js214/FS720_layout/ocxo_mount/FAB_NOTES.txt

FABRICATION NOTES

1. BOARD IS NOT IMPEDANCE CONTROLLED.

2. OVERALL THICKNESS IS 1.6 mm. MATERIAL IS
     FR4 TG155.

3. ANY STACKUP ACCEPTABLE.

4. SURFACE FINISH IS ENIG.
     GOLD THICKNESS 2 μin = 0.05 μm.

5. VIAS SHOULD BE EPOXY FILLED & CAPPED.
