js214/FS720_layout/motherboard/fs.step

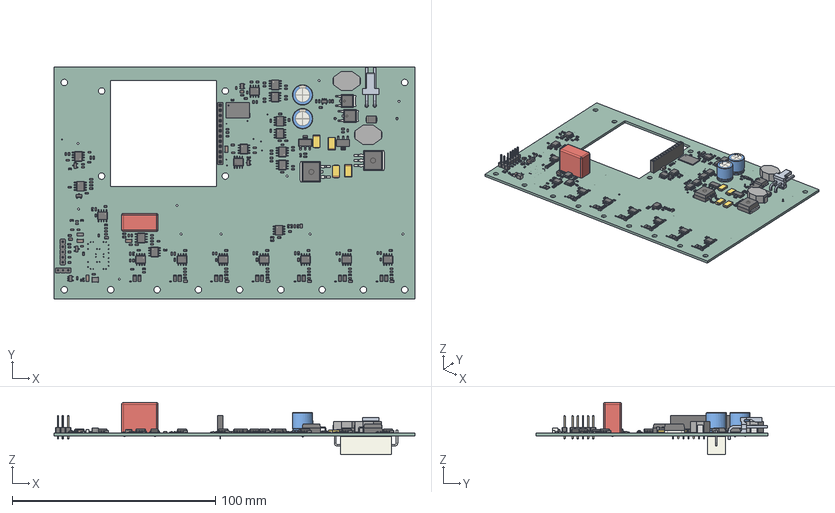
[picture p1: CAD file, 2026-08-03]
motherboard/fs.step
177.8 x 114.3 x 25.7 mm
C_1206_3216Metric x 4
R_0603_1608Metric x 88
SOT-23 x 4
C_0603_1608Metric x 59
R_1206_3216Metric x 14
SO-8_3.9x4.9mm_P1.27mm x 21
TSOT-23-5 x 3
C_0402_1005Metric x 8
L_0603_1608Metric x 21
CP_EIA_6032_15_Kemet_U x 4
C_Rect_L180mm_W90mm_P1500mm_FKS3_FKP3
L_0805_2012Metric x 9
C_0805_2012Metric x 2
a52d3817-9c39-11ed-93f0-dde97e994e83_part
a52d3818-9c39-11ed-93f0-dde97e994e83_part
a52d3819-9c39-11ed-93f0-dde97e994e83_part
CP_Radial_D100mm_P500mm x 2
PinHeader_1x05_P254mm_Vertical
a3dd6ad7-9c39-11ed-93f0-dde97e994e83_part
a3dd6ad8-9c39-11ed-93f0-dde97e994e83_part
a3dd6ad9-9c39-11ed-93f0-dde97e994e83_part
PinHeader_1x03_P254mm_Vertical
932d09b3-9c39-11ed-93f0-dde97e994e83_part x 2
932d09b4-9c39-11ed-93f0-dde97e994e83_part x 2
932d09b5-9c39-11ed-93f0-dde97e994e83_part x 2
SOT-223 x 2
PinSocket_1x12_P2.54mm_Vertical
L_1210_3225Metric
SOIC-8_3.9x4.9mm_P1.27mm
C-640389-2
D_SMB
L_1206_3216Metric
R_Axial_Power_L250mm_W90mm_P3048mm
fs_PCB
