js214/FS720_layout/ocxo_mount/ocxo_mount.step

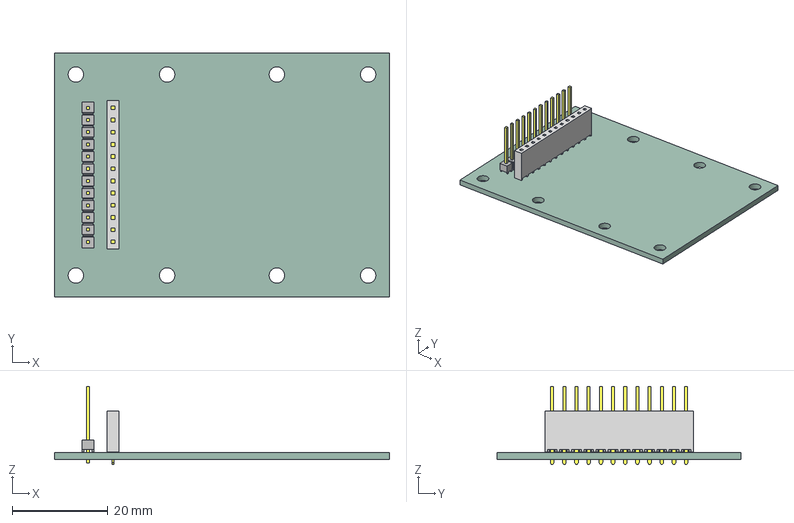
[picture p2: CAD file, 2026-08-03]
ocxo_mount/ocxo_mount.step
69.8 x 50.8 x 16.4 mm
T1SSW-112-01-G-S
P2SSW-112-01-G-S
HMTSW-112-22-L-S-440-LL_body
HMTSW-112-22-S-440-LL
ocxo_mount_PCB
