js214/FS720_layout/ocxo_mount/sch.pdf

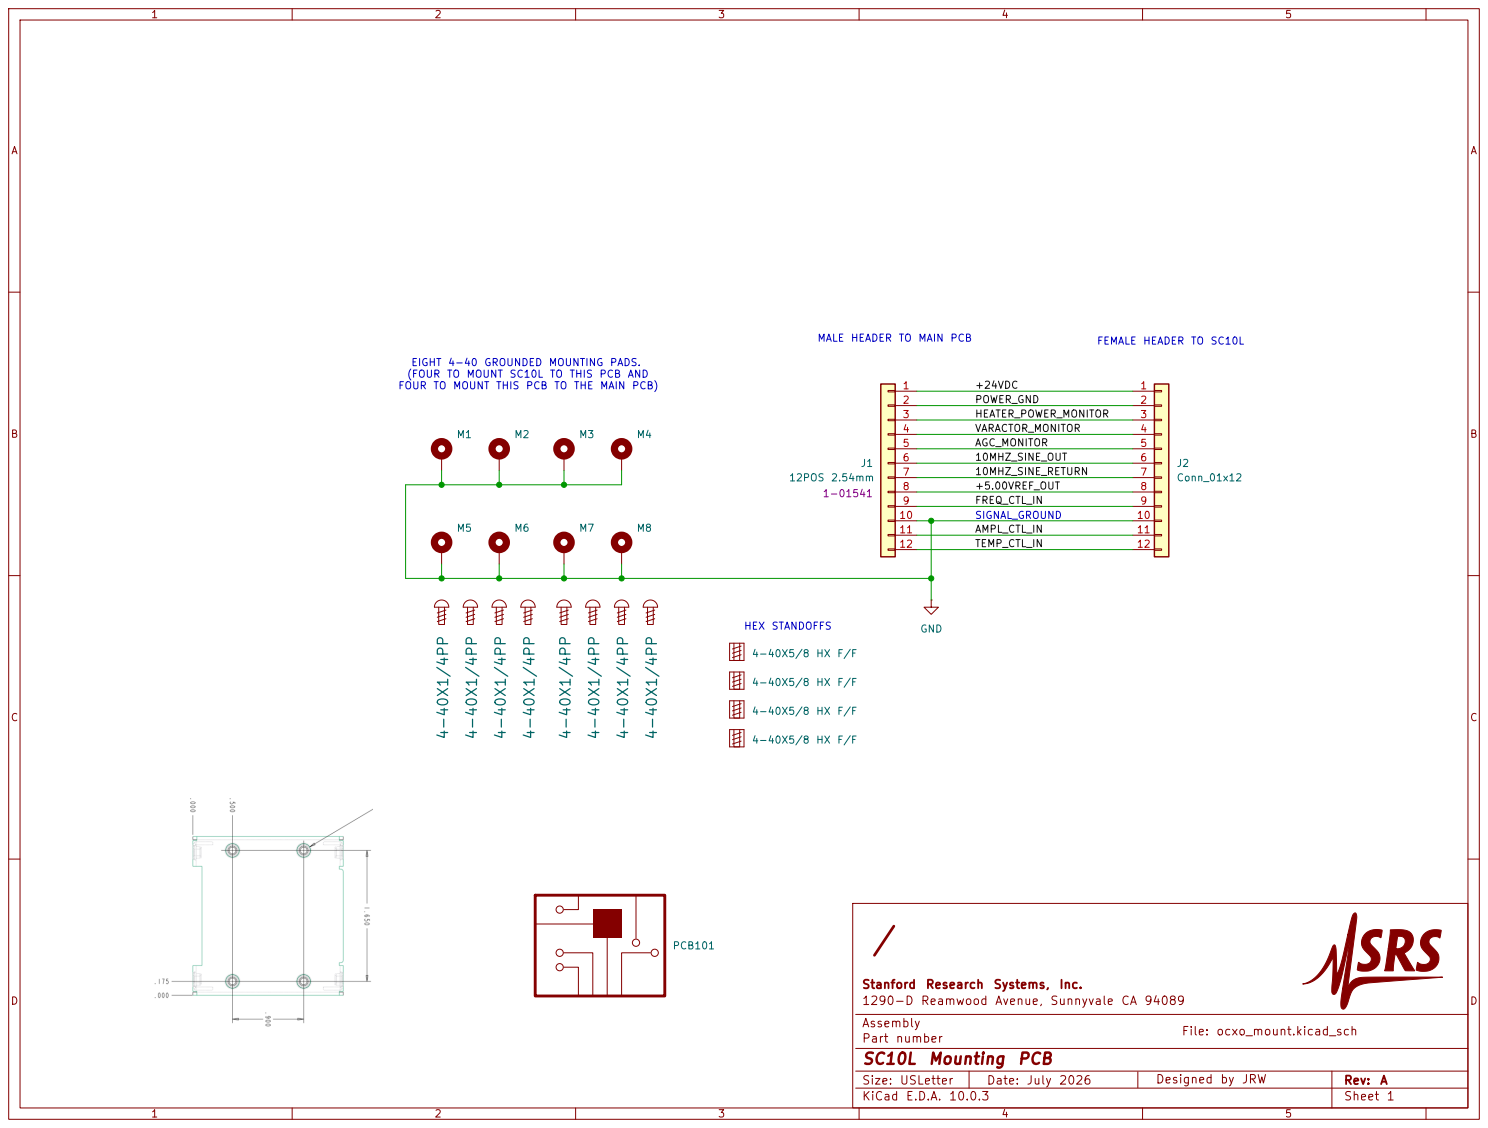
[picture p3: page 1]

11 | AMPL_CTL_IN 11
12 | 12

Stanford Research Systems, Inc.
1290-D Reamwood Avenue, Sunnyvale CA 94089
Assembly
Part number
SC10L Mounting PCB

Size: USLetter | Designed by JRW | Rev: A
KiCad E.D.A. 10.0.3 | | Sheet 1
