js214/FS720_layout/motherboard/sch.pdf

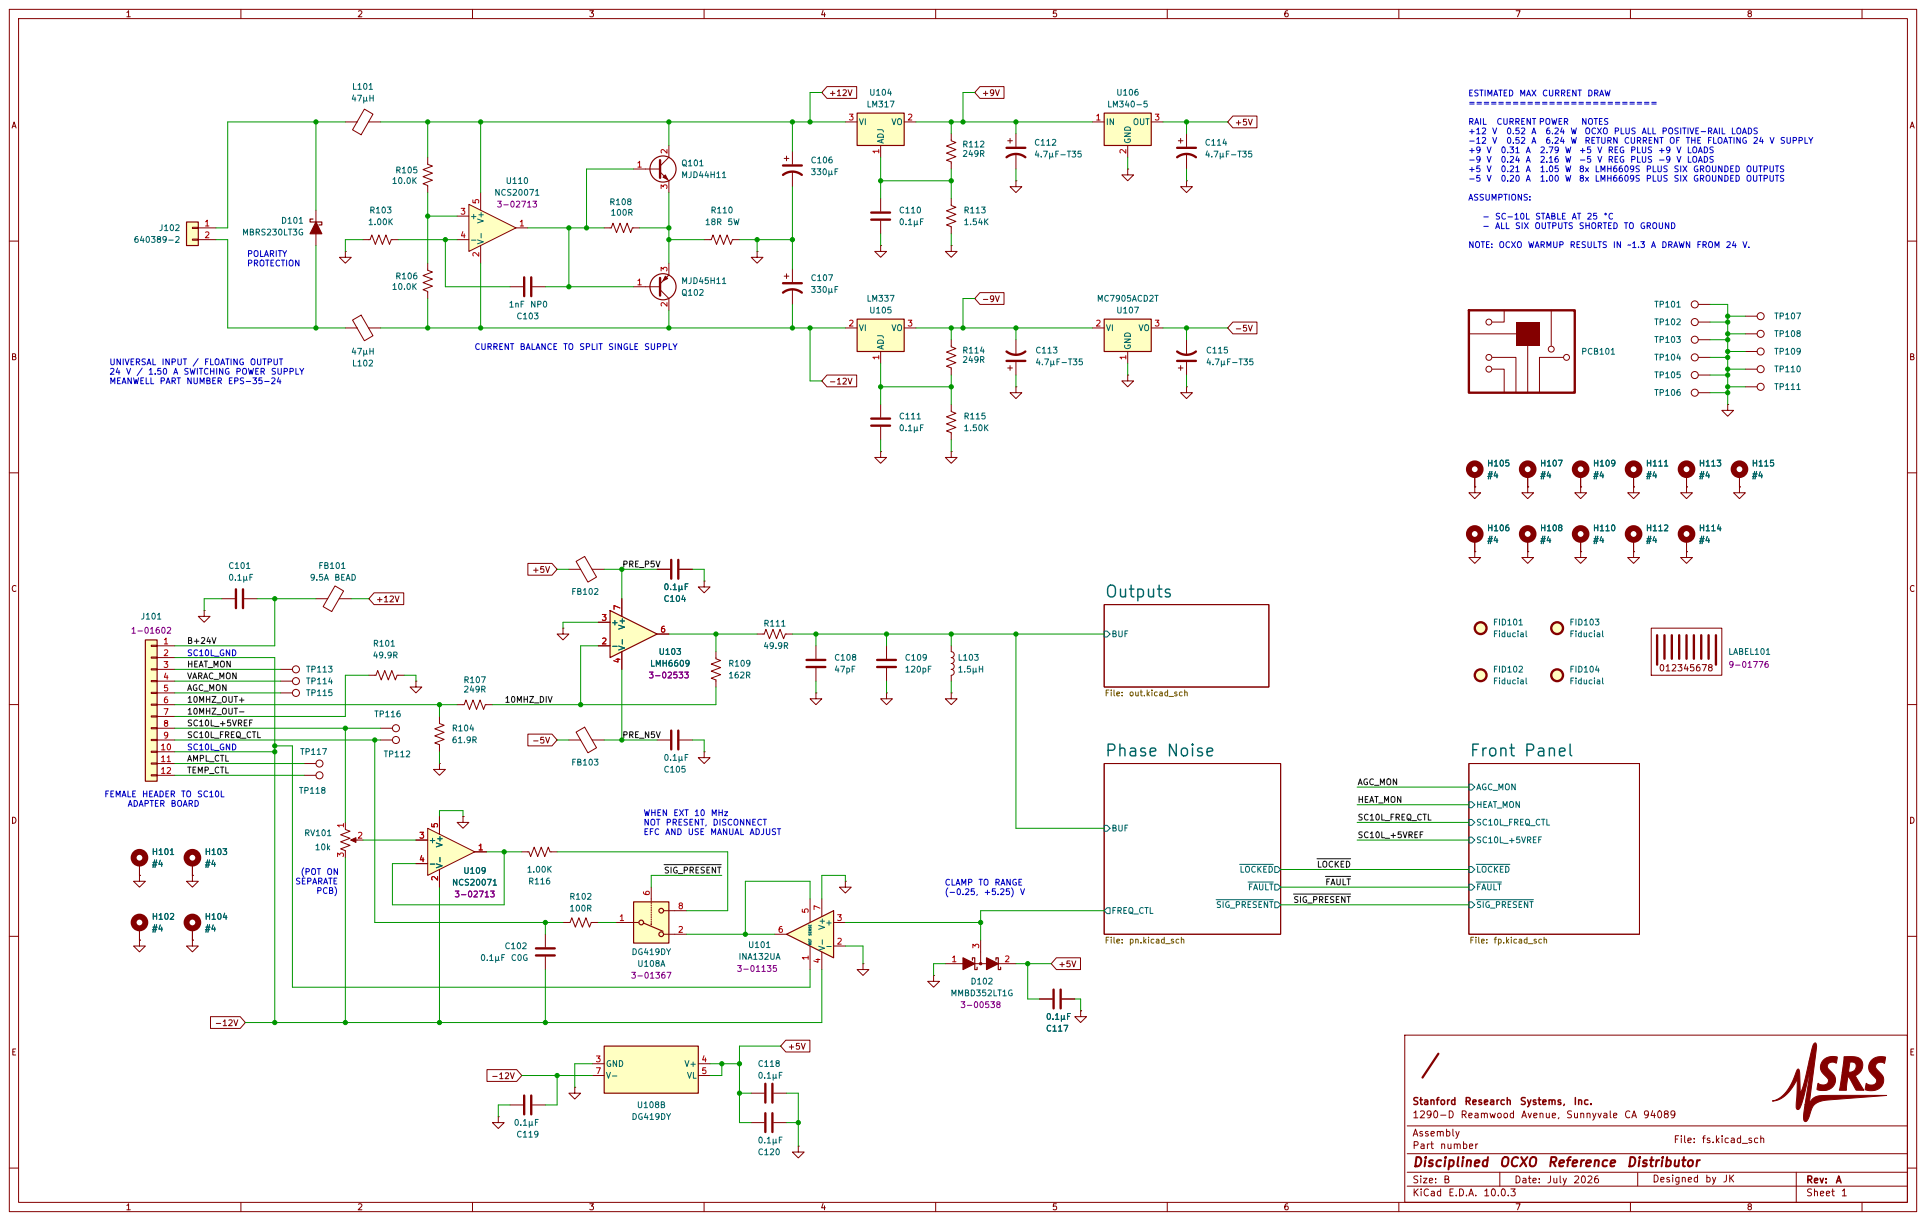
[picture p4: page 1]

ESTIMATED MAX CURRENT DRAW ==========================

ASSUMPTIONS: - SC-10L STABLE AT 25 °C - ALL SIX OUTPUTS SHORTED TO GROUND NOTE: OCXO WARMUP RESULTS IN ~1.3 A DRAWN FROM 24 V.

File: fp.kicad_sch BUF Outputs

10 SC10L_GND

SEPARATE PCB) FEMALE HEADER TO SC10L ADAPTER BOARD

Stanford Research Systems, Inc.
1290-D Reamwood Avenue, Sunnyvale CA 94089
Assembly
Part number
Disciplined OCXO Reference Distributor

Size: B | Designed by JK | Rev: A
KiCad E.D.A. 10.0.3 | | Sheet 1

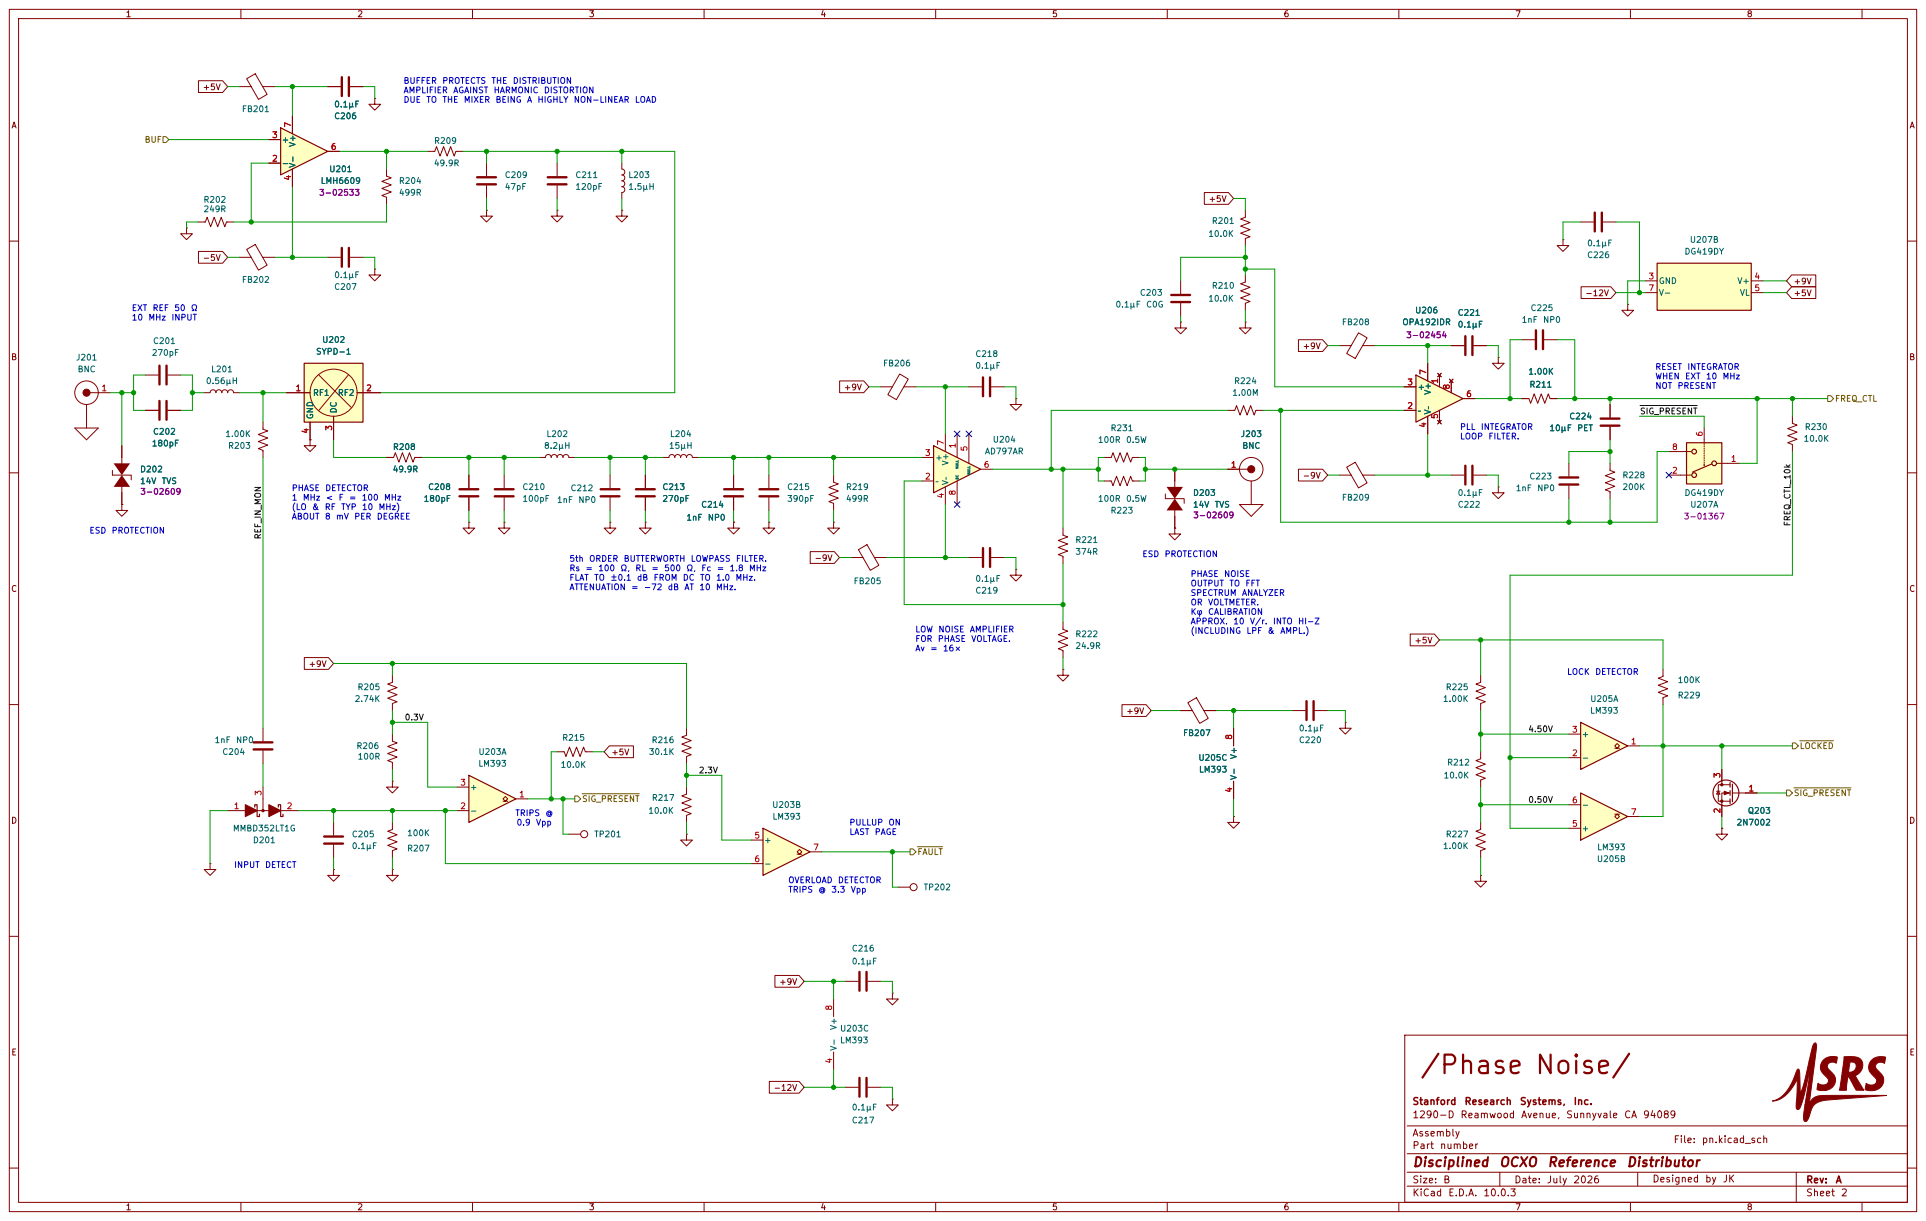
[picture p5: page 2]

BUFFER PROTECTS THE DISTRIBUTION
AMPLIFIER AGAINST HARMONIC DISTORTION
DUE TO THE MIXER BEING A HIGHLY NON-LINEAR LOAD

TRIPS @ 3.3 Vpp PHASE DETECTOR
1 MHz < F = 100 MHz
(LO & RF TYP 10 MHz) ABOUT 8 mV PER DEGREE

LOW NOISE AMPLIFIER
FOR PHASE VOLTAGE. Av = 16×

Stanford Research Systems, Inc.
1290-D Reamwood Avenue, Sunnyvale CA 94089
Assembly
Part number

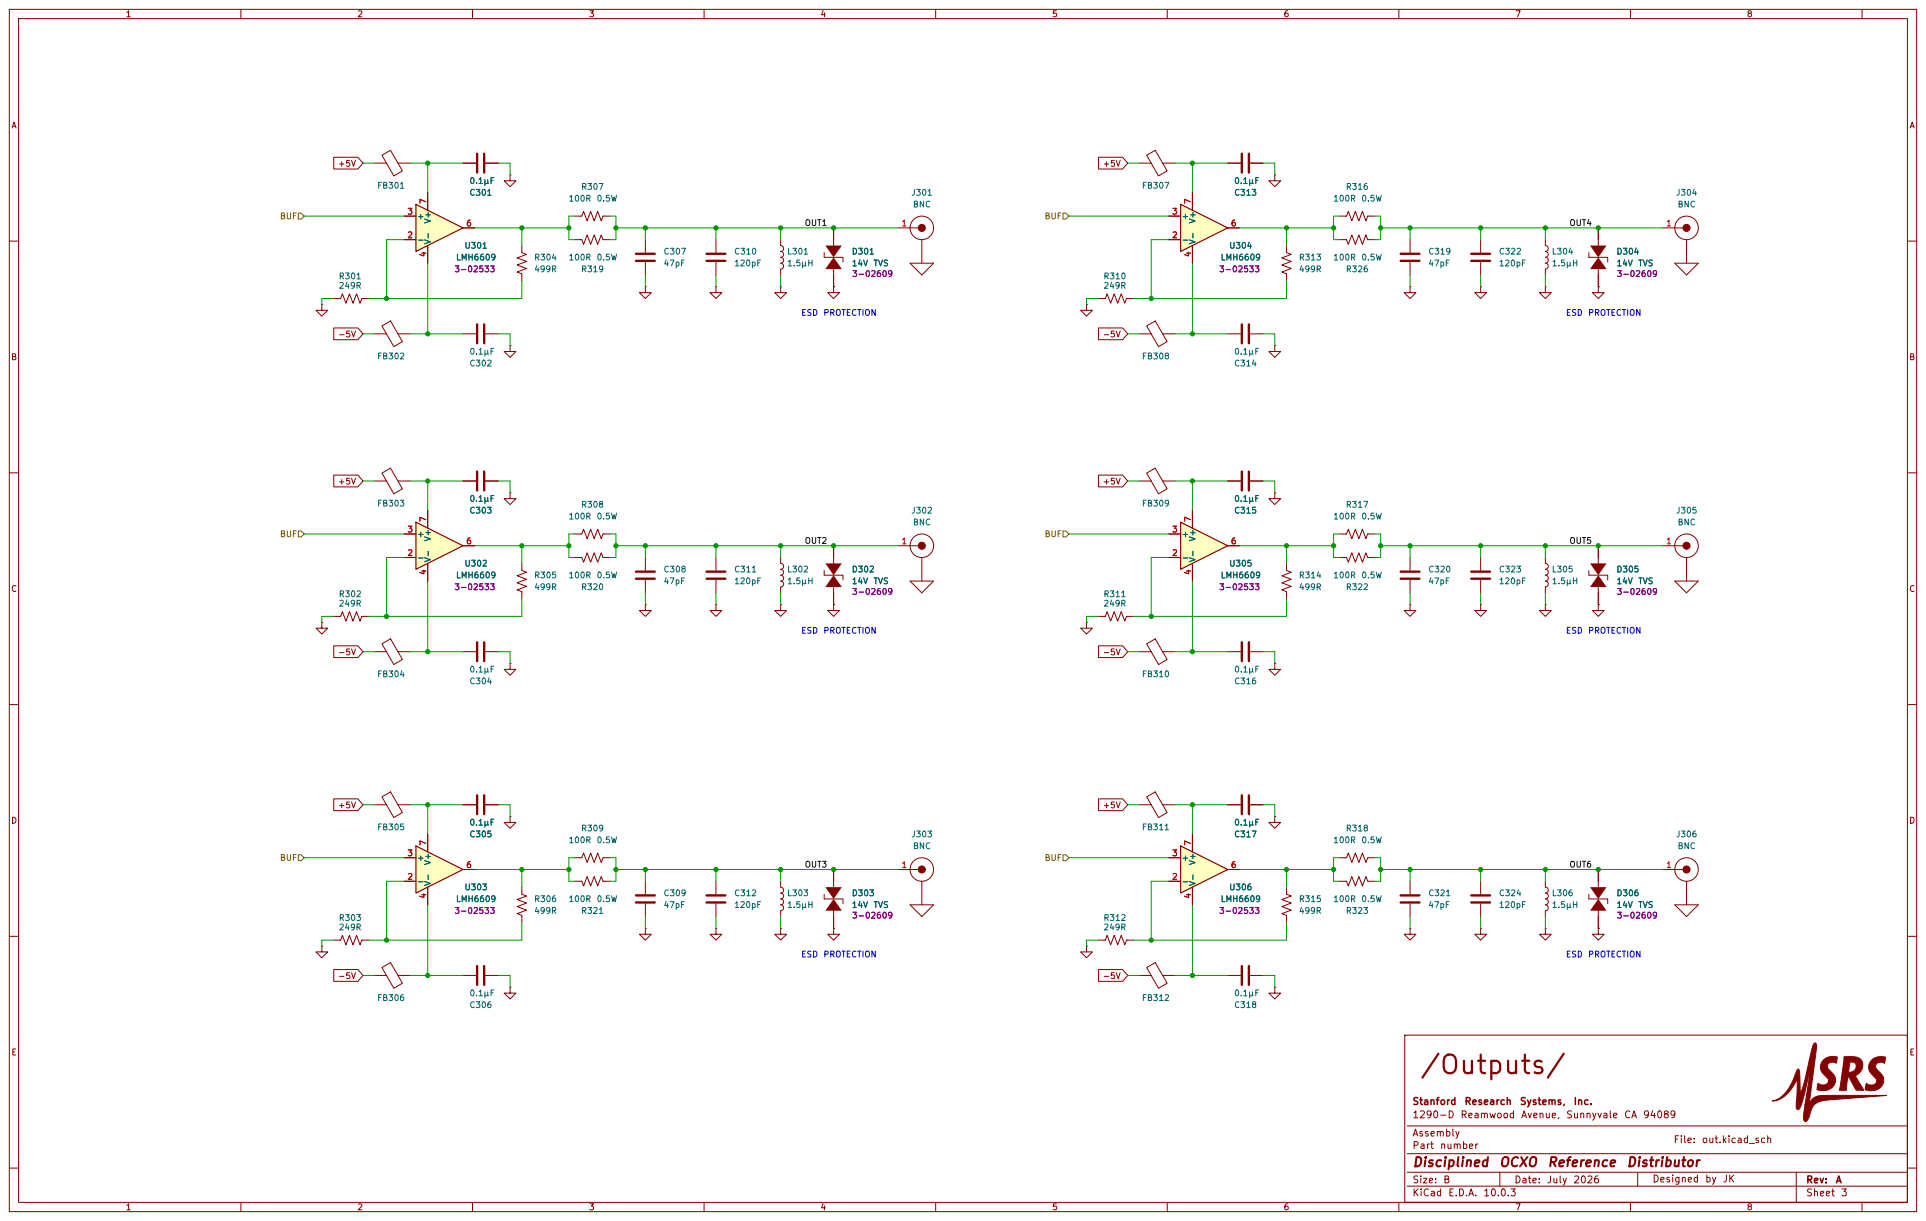
[picture p6: page 3]

Stanford Research Systems, Inc.
1290-D Reamwood Avenue, Sunnyvale CA 94089
Assembly
Part number

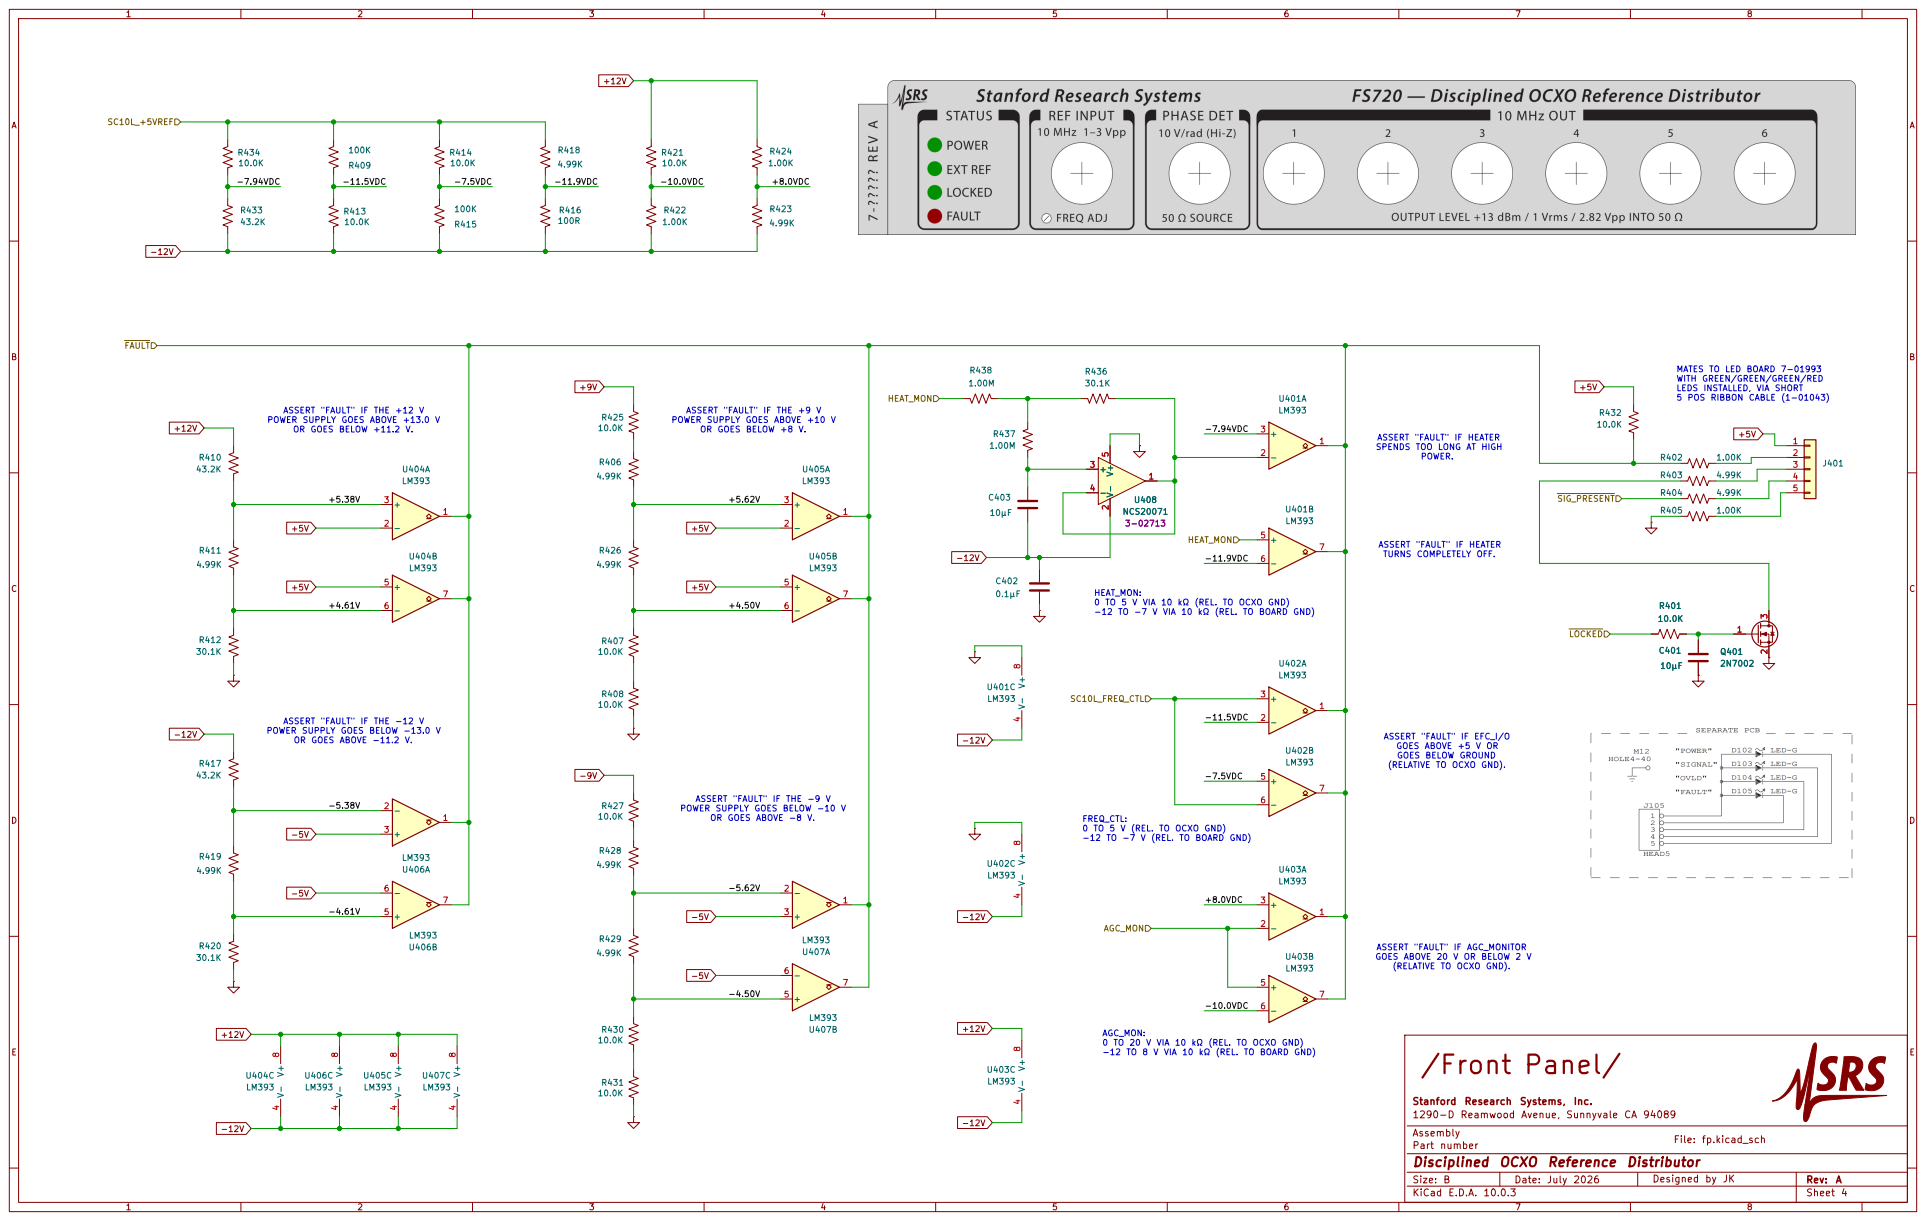
[picture p7: page 4]

(RELATIVE TO OCXO GND). ASSERT "FAULT" IF HEATER
SPENDS TOO LONG AT HIGH

LEDS INSTALLED, VIA SHORT 5 POS RIBBON CABLE (1-01043)

ASSERT "FAULT" IF THE +12 V POWER SUPPLY GOES ABOVE +13.0 V OR GOES BELOW +11.2 V.

ASSERT "FAULT" IF AGC_MONITOR
GOES ABOVE 20 V OR BELOW 2 V

AGC_MON: 0 TO 20 V VIA 10 kΩ (REL. TO OCXO GND) -12 TO 8 V VIA 10 kΩ (REL. TO BOARD GND)

Stanford Research Systems, Inc.
1290-D Reamwood Avenue, Sunnyvale CA 94089
Assembly
Part number
