js214/FS720_layout/motherboard/7-01925-701 PCB FS720.pdf

| REVISIONS
REV | DESCRIPTION | | | DATE | APPROVED

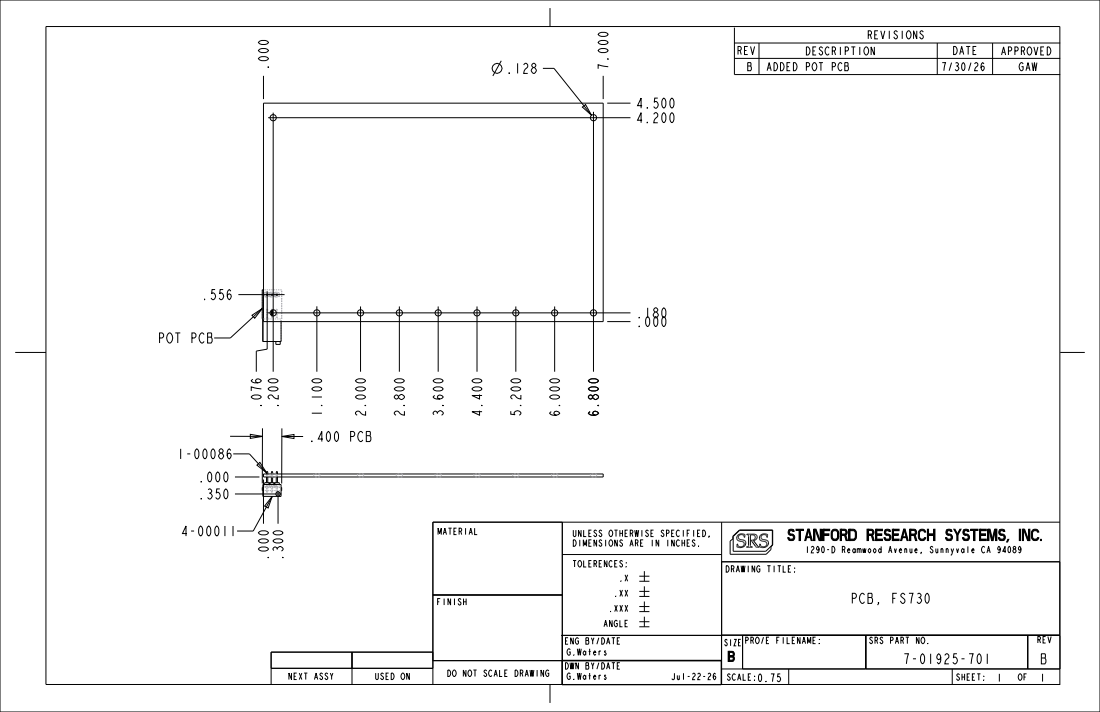
[picture p8: page 1]
DRAWING TITLE:; SCALE:; SHEET:; STANFORD; RESEARCH SYSTEMS,; INC.; 1290-D Reamwood; Avenue, Sunnyvale CA 94089; .X .XX .XXX ANGLE; FINISH; .400 PCB; PCB, FS730; G.Waters; Jul-22-26; POT PCB

B | ADDED POT PCB | 7/30/26 | GAW

MATERIAL | UNLESS OTHERWISE SPECIFIED, DIMENSIONS ARE IN INCHES.

TOLERENCES:

ENG BY/DATE G.Waters | SIZE | PRO/E FILENAME: | SRS PART NO. 7-01925-701 | REV B

DO NOT SCALE DRAWING | | | DWN BY/DATE

NEXT ASSY | USED ON
