js214/FS720_layout/ocxo_mount/pcb.pdf

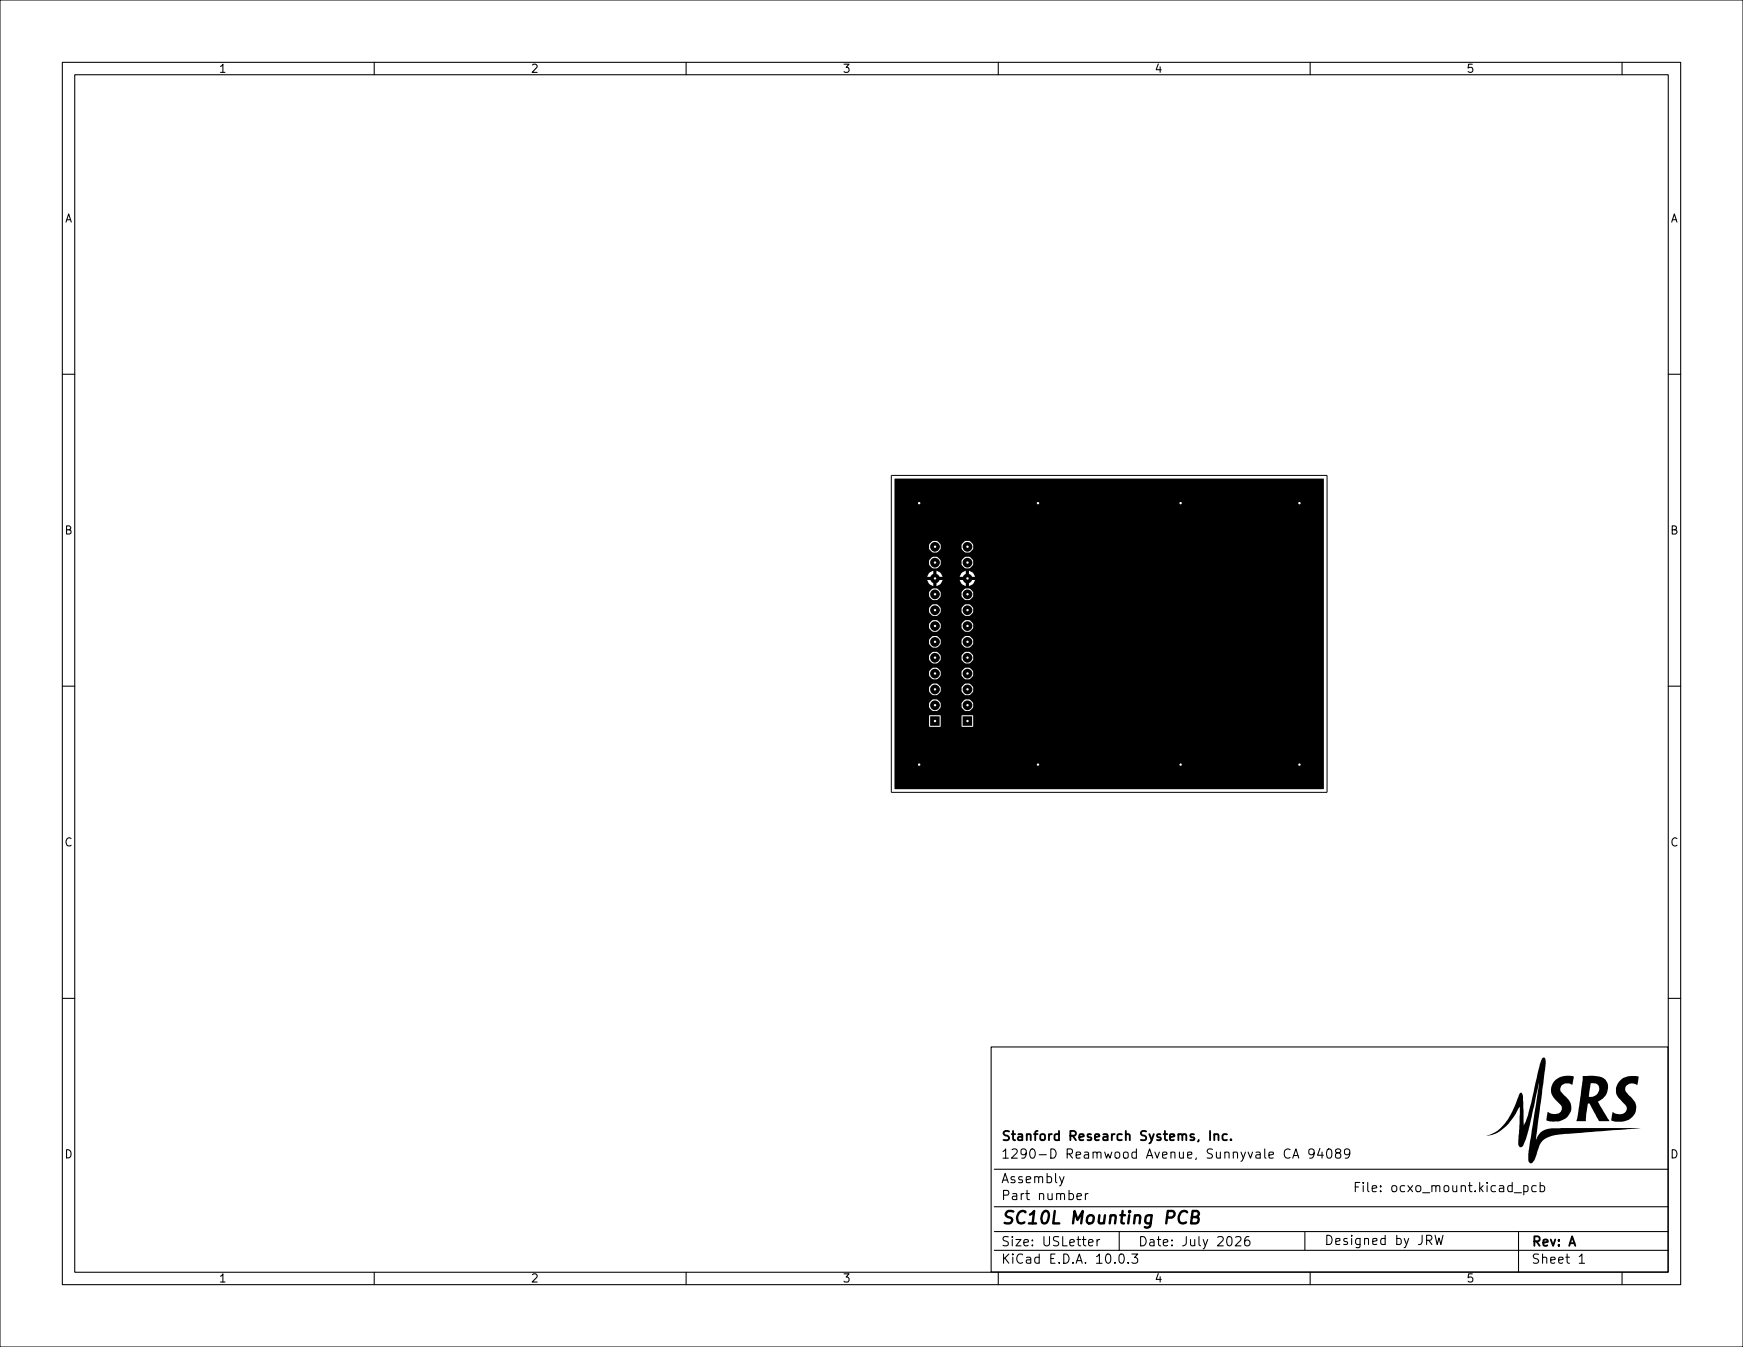
[picture p9: page 1]

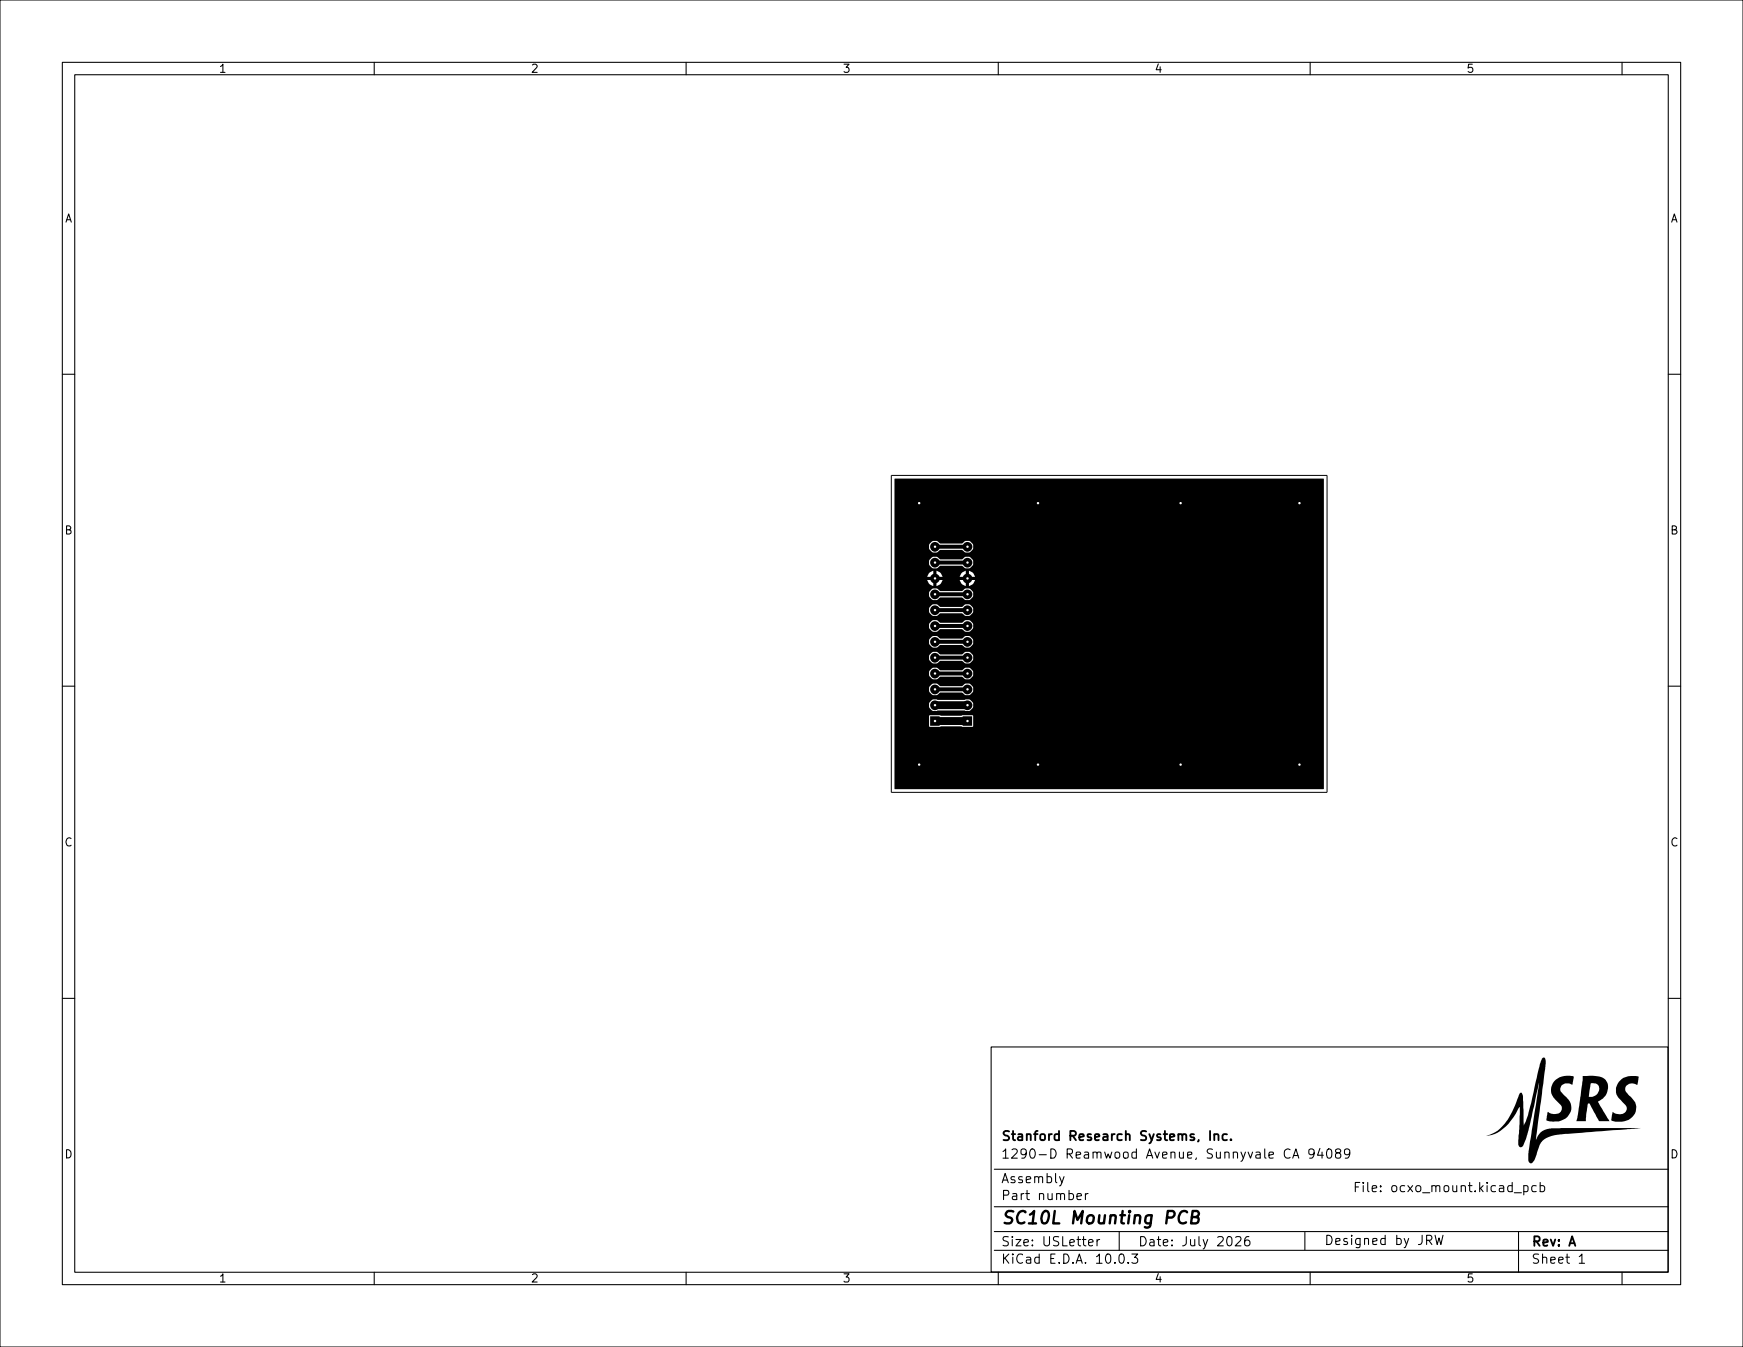
[picture p10: page 2]

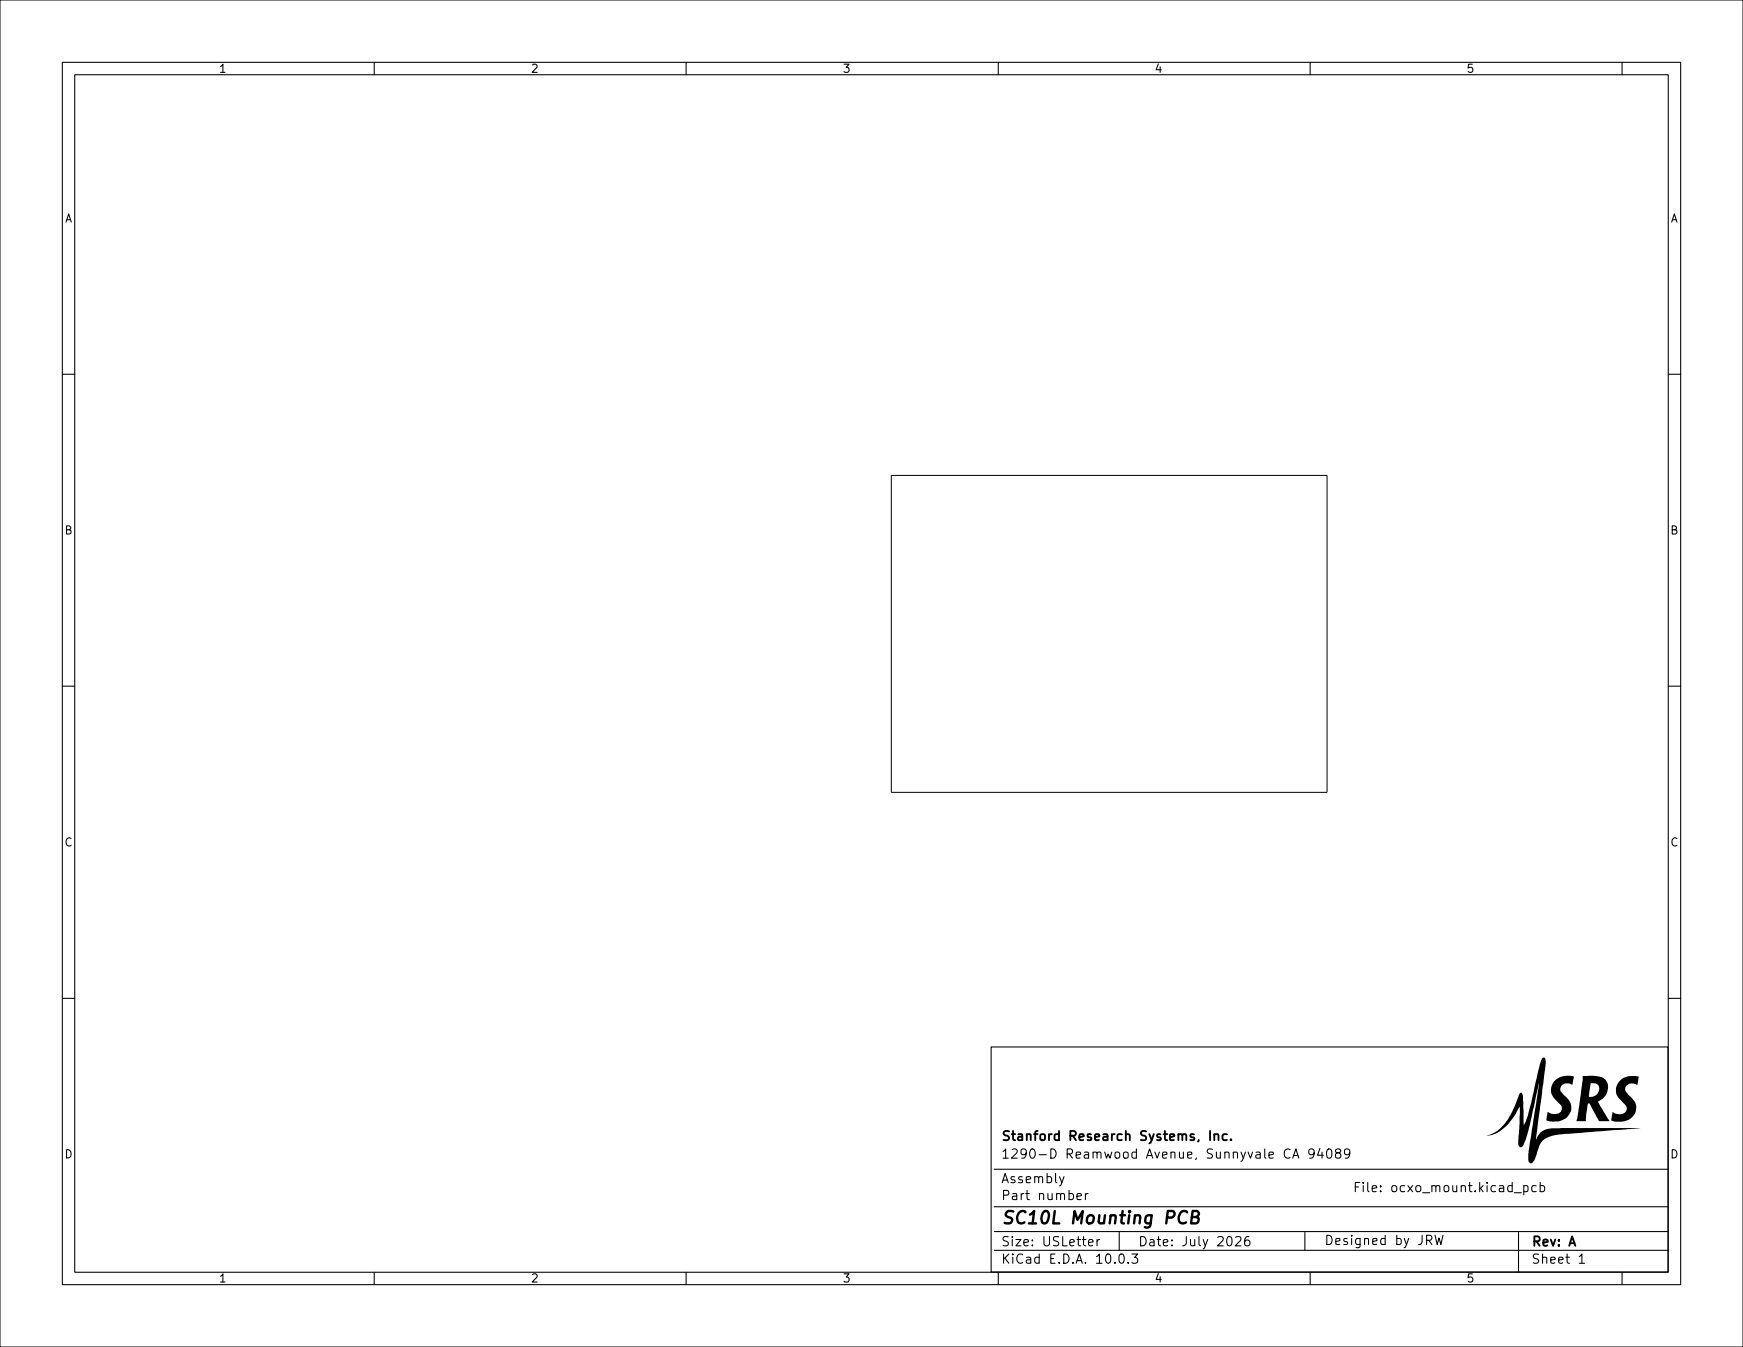
[picture p11: page 3]

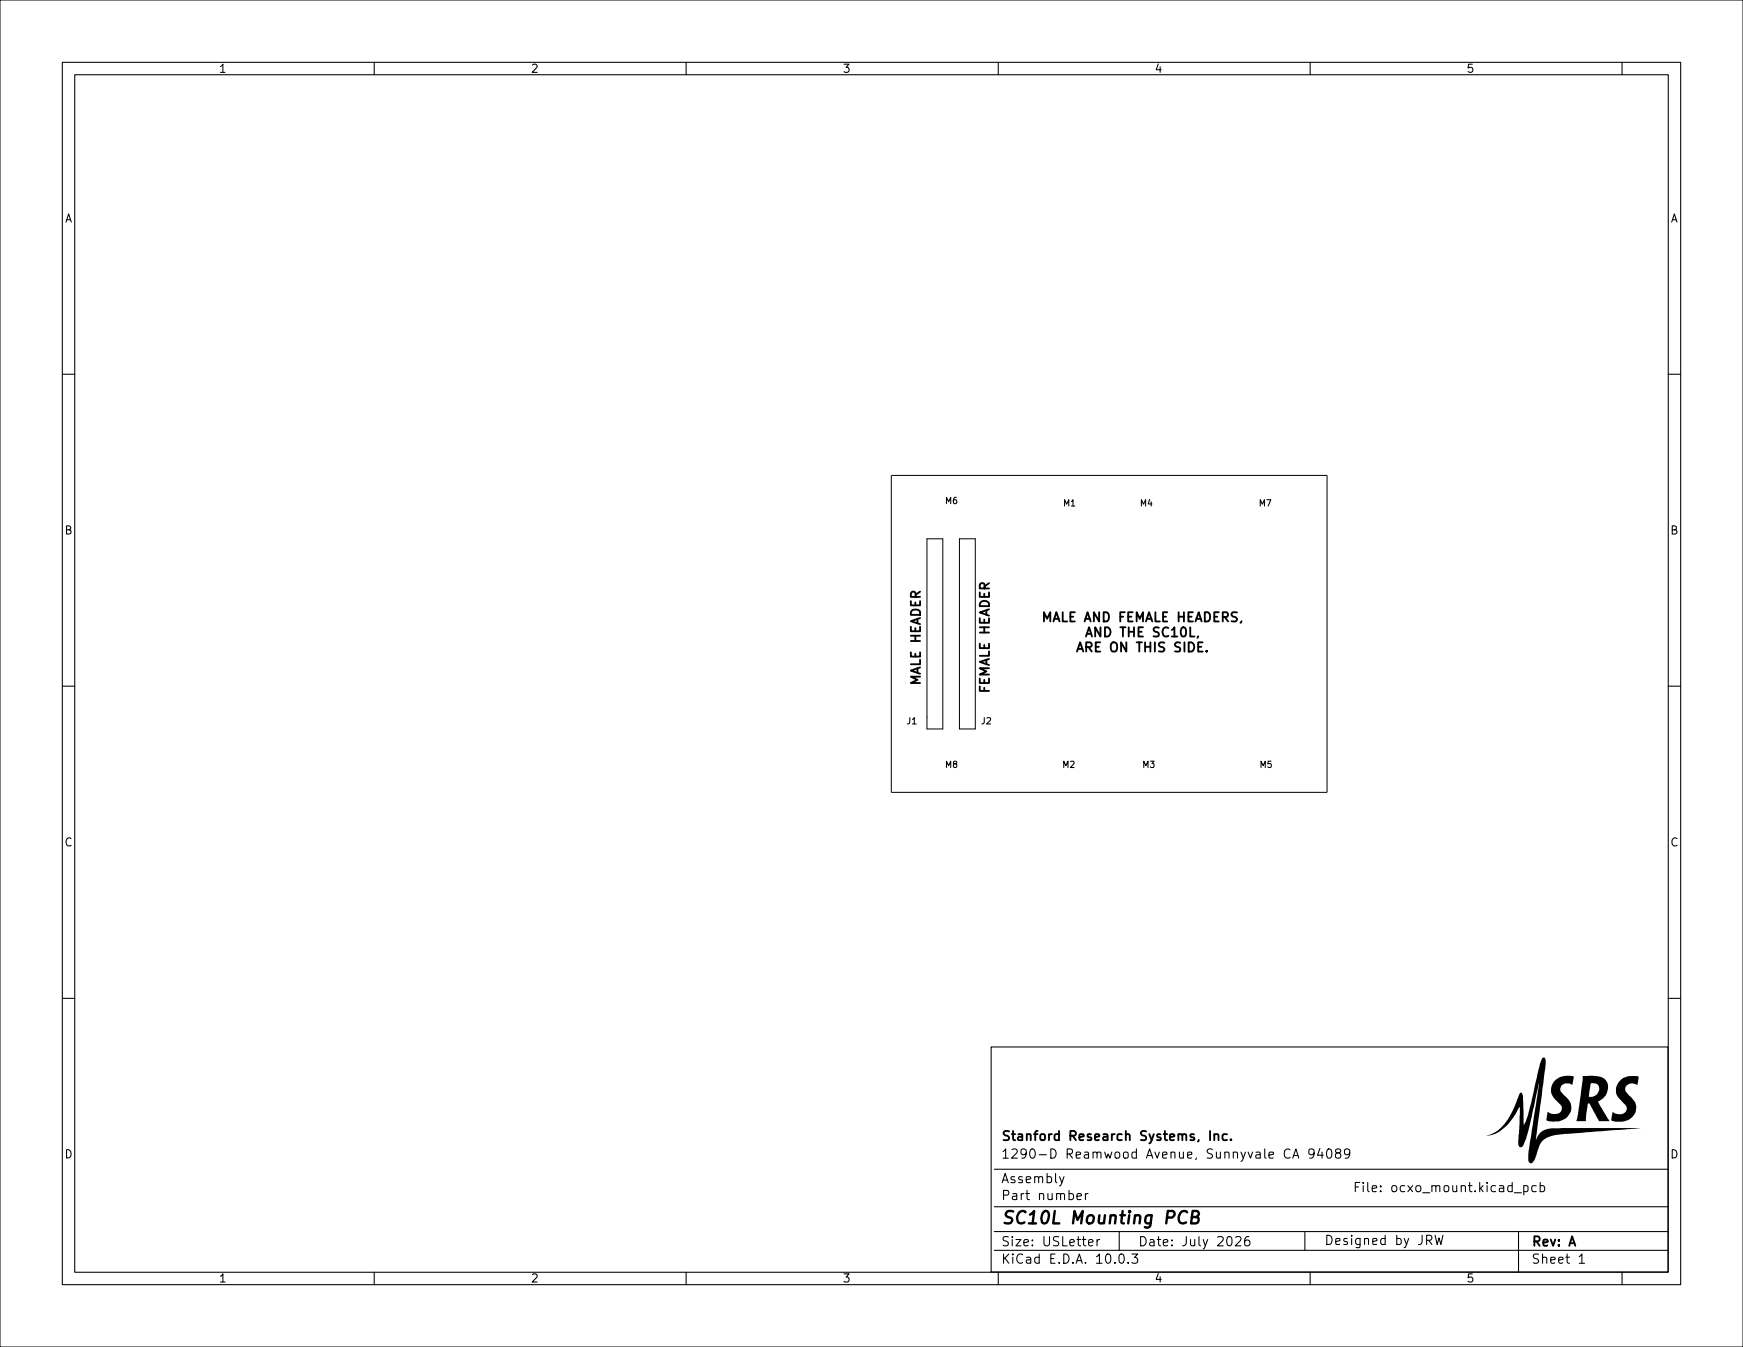
[picture p12: page 5]

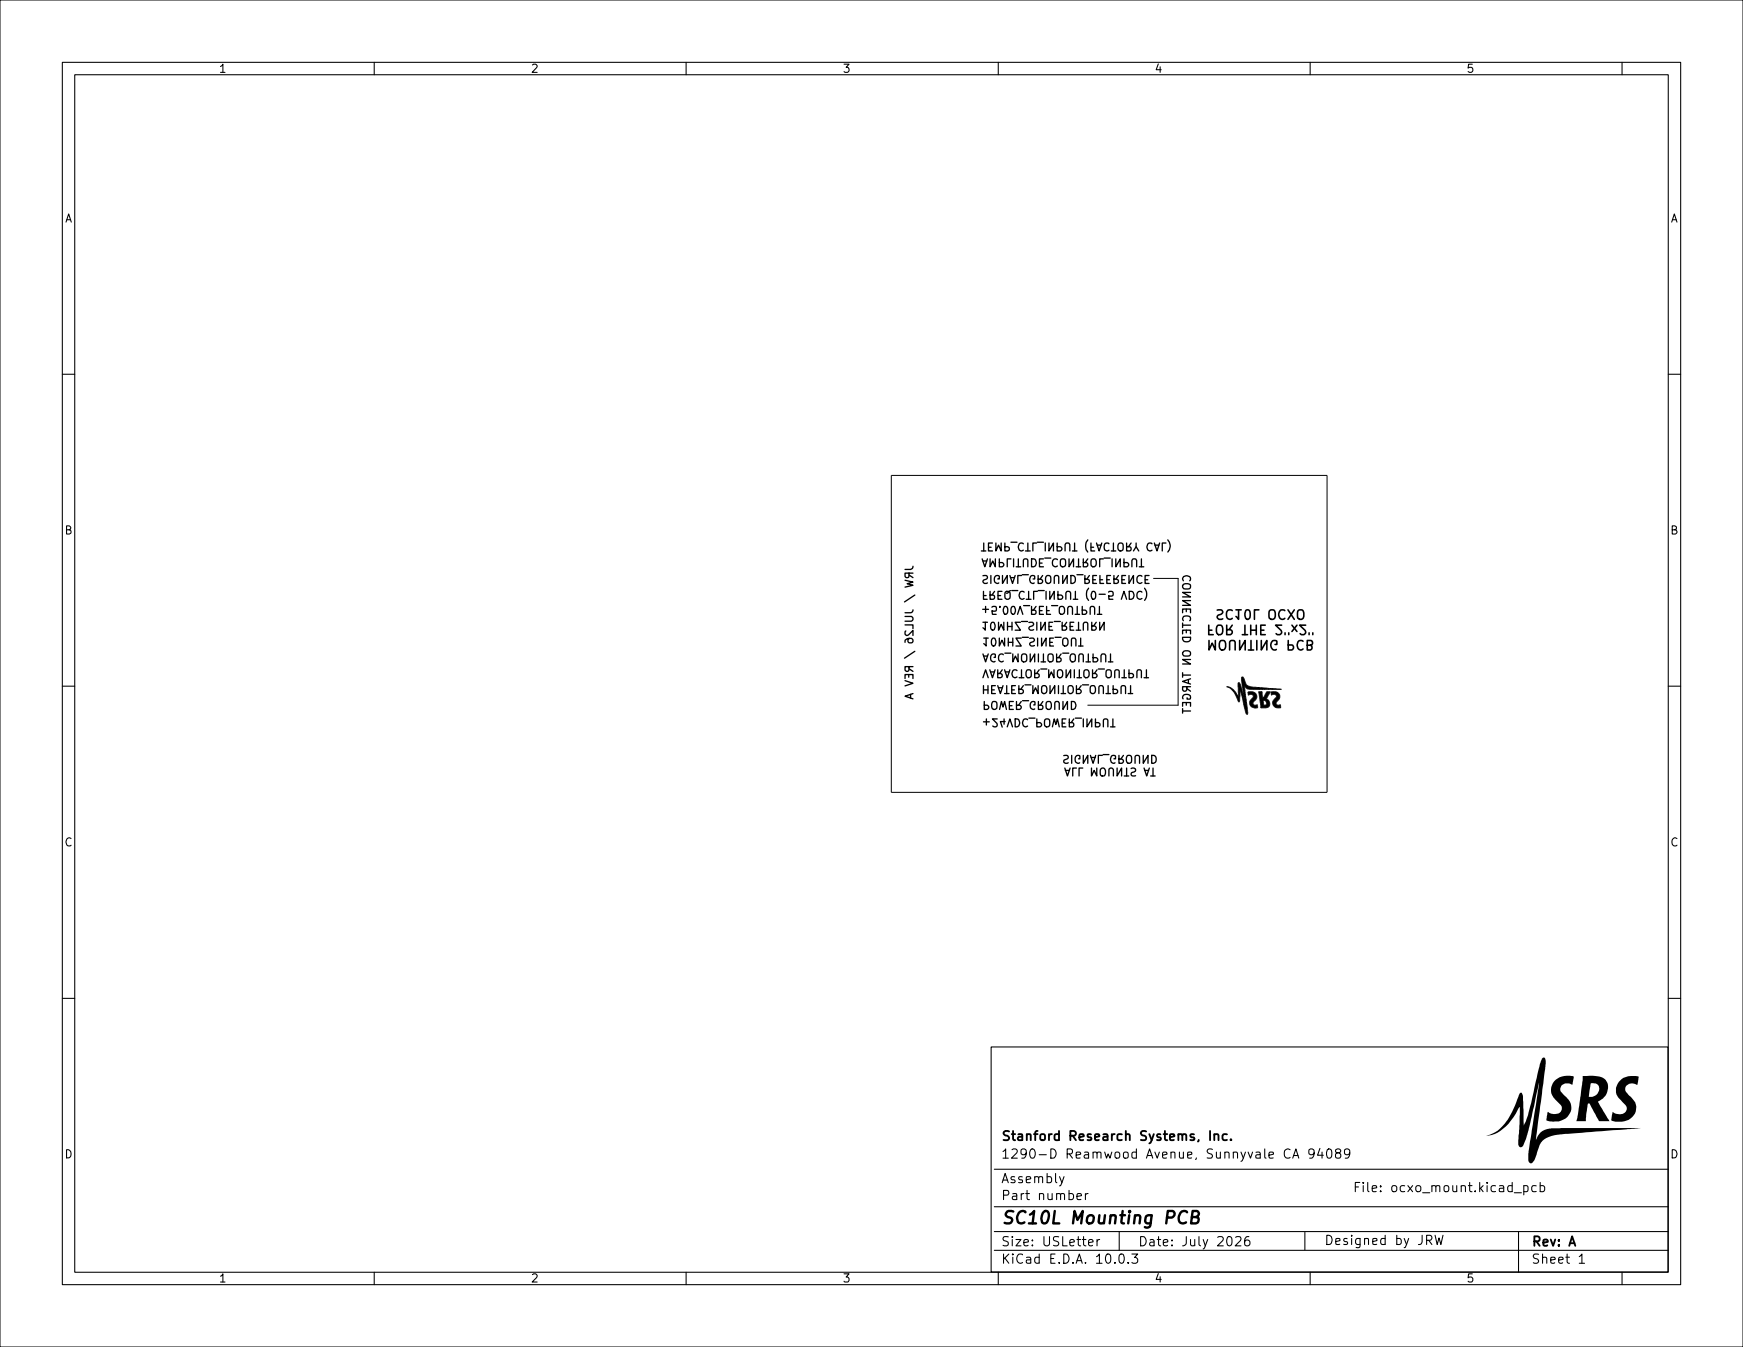
[picture p13: page 6]

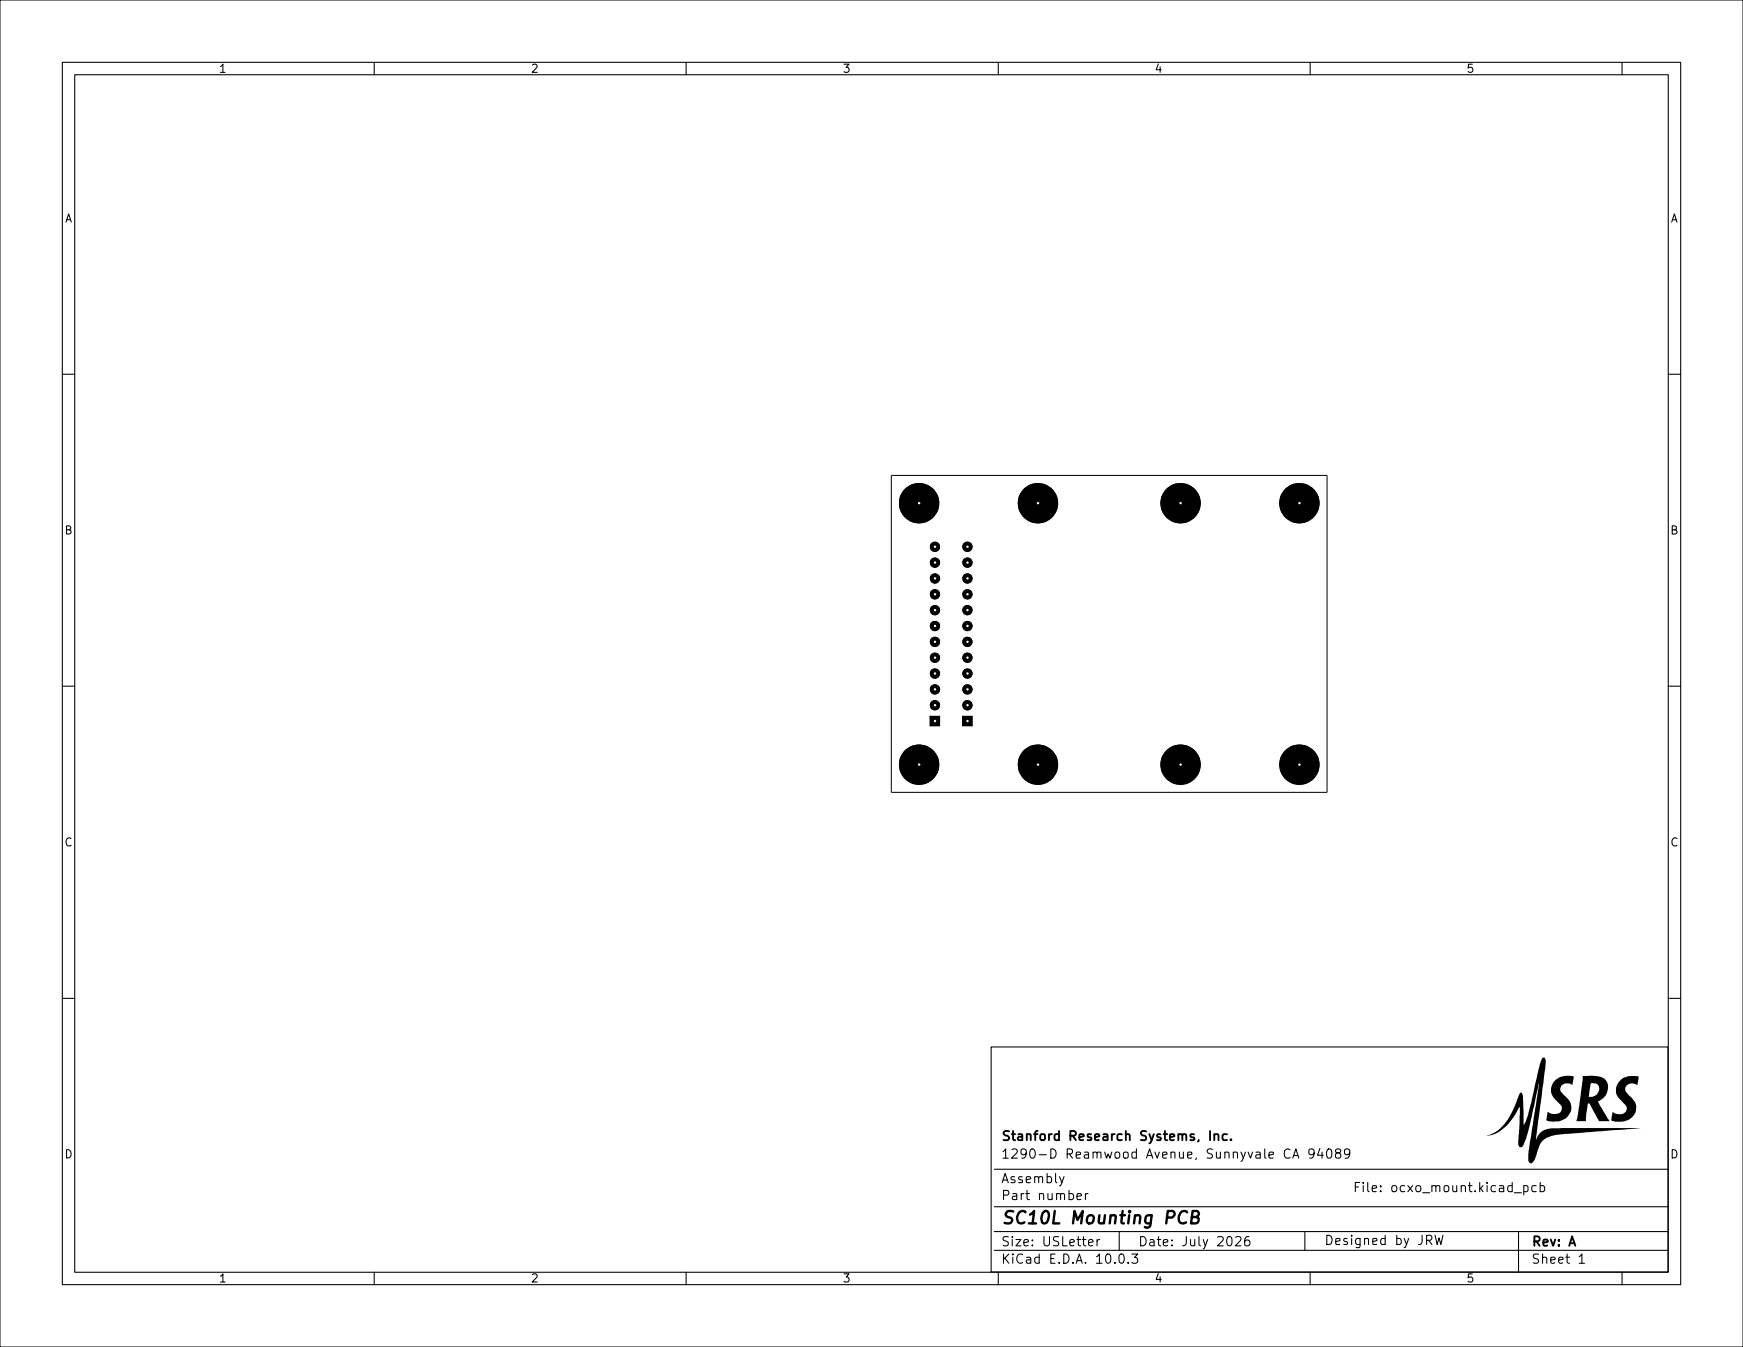
[picture p14: page 7]
