js214/FS720_layout/ocxo_mount/ocxo_mount.kicad_pcb

## KiCad design ocxo_mount/ocxo_mount.kicad_pcb (2026-08-03)

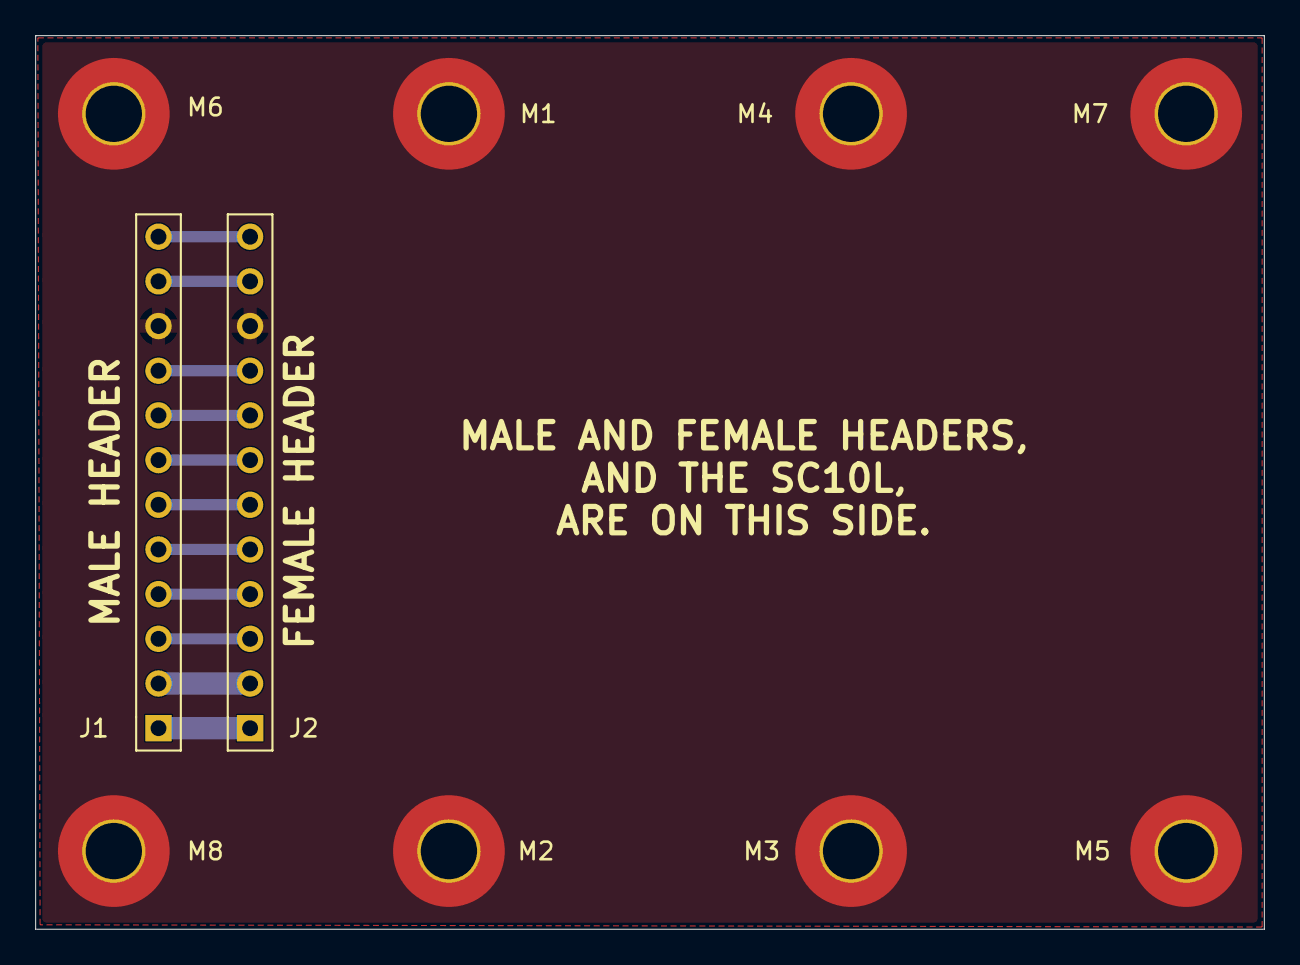
[picture p27: board ocxo_mount.kicad_pcb from above]

Board: 2 copper layers, 69.8 x 50.8 mm, 10 parts (0 on the bottom side), 12 nets.

Parts:
J1: 12POS 2.54mm; HDR1X12
J2: Conn_01x12; HDR1X12
M1, M2, M3, M4, M5, M6, M7, M8: MountingPad_4-40; Hole_4-40

Connections:
/10MHZ_SINE_OUT: J1.6, J2.6
/10MHZ_SINE_RETURN: J1.7, J2.7
/+5.00VREF_OUT: J1.8, J2.8
/+24VDC: J1.1, J2.1
/AGC_MONITOR: J1.5, J2.5
/AMPL_CTL_IN: J1.11, J2.11
/FREQ_CTL_IN: J1.9, J2.9
/HEATER_POWER_MONITOR: J1.3, J2.3
/POWER_GND: J1.2, J2.2
/TEMP_CTL_IN: J1.12, J2.12
/VARACTOR_MONITOR: J1.4, J2.4
GND: J1.10, J2.10, M1.1 (1_1), M2.1 (1_1), M3.1 (1_1), M4.1 (1_1), M5.1 (1_1), M6.1 (1_1), M7.1 (1_1), M8.1 (1_1)
