js214/FS720_layout/motherboard/fs.kicad_pcb

## KiCad design motherboard/fs.kicad_pcb (2026-08-03)

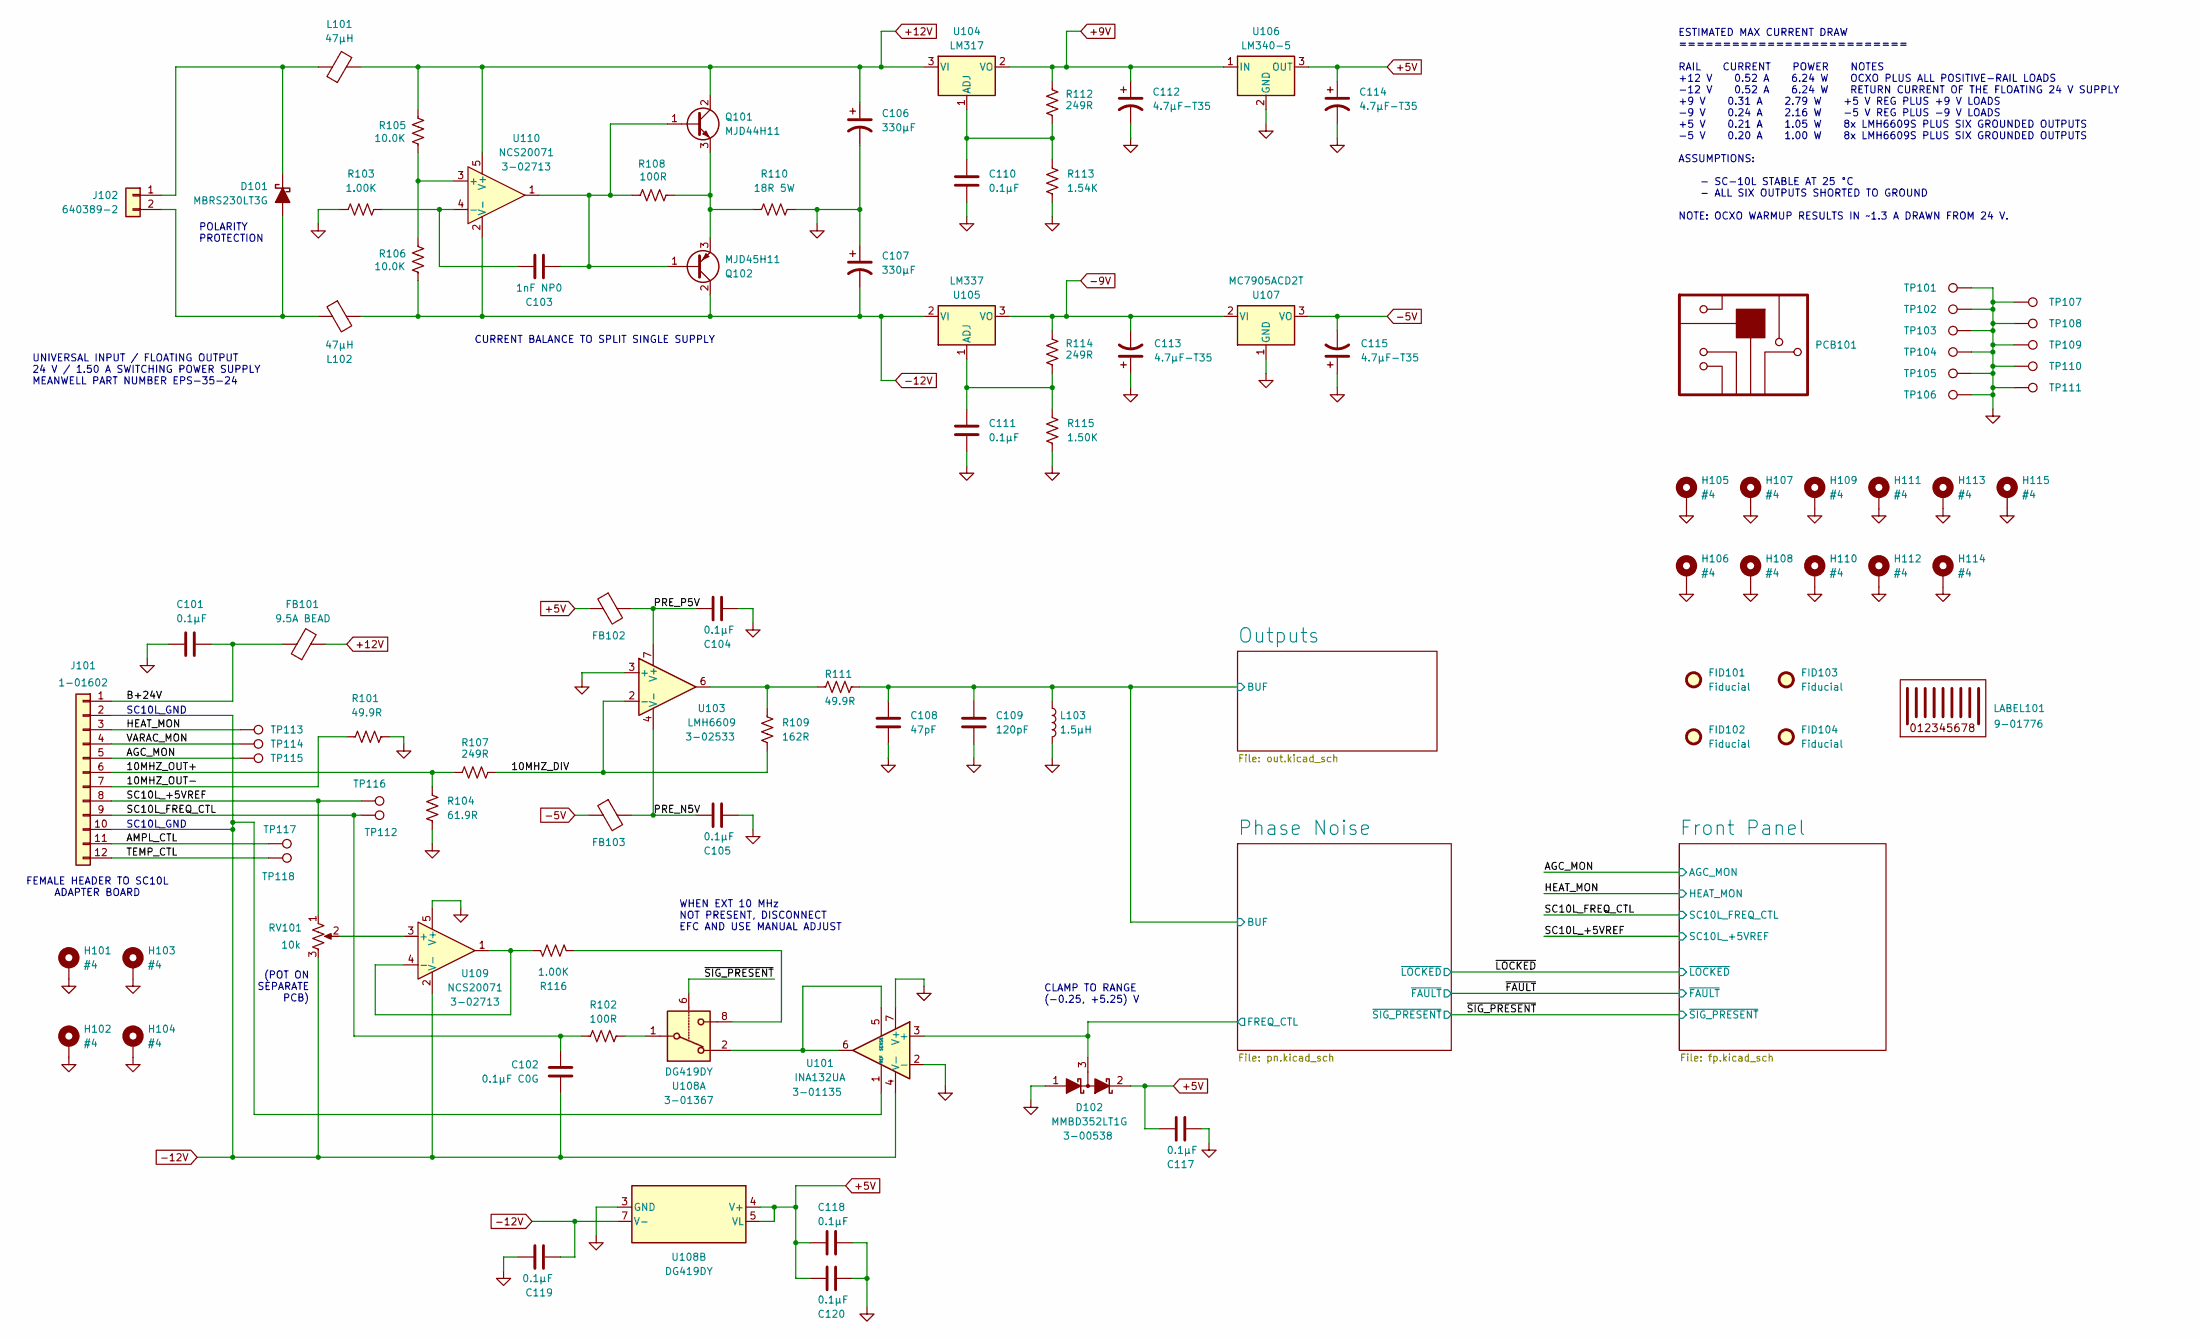
[picture p28: schematic fs.kicad_sch, ${TITLE}]

Parts:
C101, C104, C105, C110, C111, C117, C118, C119, C120: 0.1μF; C_0603_1608Metric; Voltage 50V; MPN 06035C104KAT4A; JLCPCB C14663
C102: 0.1μF C0G; C_1206_3216Metric; Voltage 50V; MPN GRT31C5C1H104FA02L; JLCPCB C3839854
C103: 1nF NP0; C_0603_1608Metric; Voltage 50V; MPN C0603C102J5GACTU; JLCPCB C2181873
C106: 330μF; CP_Radial_D10.0mm_P5.00mm; Voltage 35V; MPN EEU-FC1V331; JLCPCB C14745
C107: 330μF; CP_Radial_D10.0mm_P5.00mm; Voltage 35V; MPN EEU-FC1V331; JLCPCB EEU-FC1V331
C108: 47pF; C_0603_1608Metric; Voltage 50V; MPN C0603C470J5GACTU; JLCPCB C2167347
C109: 120pF; C_0603_1608Metric; Voltage 50V; MPN C0603C121J5GACTU; JLCPCB C2168575
C112, C113, C114, C115: 4.7μF-T35; CP_EIA-6032-15_Kemet-U; Voltage 35V; MPN TAJC475M035RNJ; JLCPCB C11378
D101: MBRS230LT3G; D_SMB; MPN MBRS230LT3G; JLCPCB C236135
D102: MMBD352LT1G; SOT-23; MPN MMBD352LT1G; JLCPCB C463549
FB101: 9.5A BEAD; SMB2.5R-2; MPN SMB2.5R-2; JLCPCB C3716465
FB102, FB103: 742863160; L_0603_1608Metric; MPN 742863160; JLCPCB C2650942
FID101, FID102, FID103, FID104: Fiducial; Fiducial_0.5mm_Mask1.5mm; MPN --; JLCPCB --
H101, H102, H103, H104, H105, H106, H107, H108, H109, H110, H111, H112, H113, H114, H115: #4; MountingHole_3.2mm_M3_DIN965_Pad; MPN --; JLCPCB --
J101: Header; PinSocket_1x12_P2.54mm_Vertical; MPN 1-215299-2; JLCPCB C7155422
J102: 640389-2; 640389-2_TYC; MPN 640389-2; JLCPCB C305837
L101, L102: 47μH; PM3316; MPN PM3316-470M-RC; JLCPCB C1329573
L103: 1.5μH; L_0805_2012Metric; MPN MLF2012A1R5JTD25; JLCPCB C76794
LABEL101: Label; LABEL_1in_0.25in; MPN 10011975; JLCPCB --
PCB101: PCB; MPN --; JLCPCB --
Q101: MJD44H11; TO-252-2; MPN MJD44H11G; JLCPCB C36608
Q102: MJD45H11; TO-252-2; MPN MJD45H11G; JLCPCB C5424
R101, R111: 49.9R; R_0603_1608Metric; MPN TFCR0603-16W-E-49R9FT; JLCPCB C23185
R102, R108: 100R; R_0603_1608Metric; MPN RR0816P-101-D; JLCPCB C22775
R103, R116: 1.00K; R_0603_1608Metric; MPN RR0816P-102-D; JLCPCB C22548
R104: 61.9R; R_0603_1608Metric; MPN TFCR0603-16W-E-61R9F; JLCPCB C101138
R105, R106: 10.0K; R_0603_1608Metric; MPN TFCR0603-16W-E-1002FT; JLCPCB C98220
R107, R112, R114: 249R; R_0603_1608Metric; MPN TFCR0603-16W-E-2490FT; JLCPCB C22919
R109: 162R; R_0603_1608Metric; MPN TFCR0603-16W-E-1620F; JLCPCB C185368
R110: 18R 5W; R_Axial_Power_L25.0mm_W9.0mm_P30.48mm; MPN CW00518R00JE12; JLCPCB --
R113: 1.54K; R_0603_1608Metric; MPN TFCR0603-16W-E-1541F; JLCPCB C22842
R115: 1.50K; R_0603_1608Metric; MPN TFCR0603-16W-E-1501FT; JLCPCB C22843
RV101: 10k; PinHeader_1x03_P2.54mm_Vertical
TP101, TP102, TP103, TP104, TP105, TP106, TP107, TP108, TP109, TP110, TP111: TestPoint; TestPoint_THTPad_D2.0mm_Drill1.0mm
TP112, TP113, TP114, TP115, TP116, TP117, TP118: TestPoint; TestPoint_THTPad_D1.0mm_Drill0.5mm; MPN --; JLCPCB --
U101: INA132UA; SO-8_3.9x4.9mm_P1.27mm; MPN INA132UA/2K5; JLCPCB C38199
U103: LMH6609; SO-8_3.9x4.9mm_P1.27mm; MPN LMH6609MAX/NOPB; JLCPCB C2060005
U104: LM317; SOT-223-3_TabPin2; MPN LM317DCYR; JLCPCB C51466
U105: LM337; SOT-223-3_TabPin2; MPN LM337IMPX/NOPB; JLCPCB C74510
U106: LM340-5; TO-263-3_TabPin2; MPN LM340SX-5.0/NOPB; JLCPCB C2870849
U107: MC7905ACD2T; TO-263-2; MPN MC7905ACD2TR4G; JLCPCB C898727
U108: DG419DY; SO-8_3.9x4.9mm_P1.27mm; MPN DG419DY-T1-E3; JLCPCB C6581
U109, U110: NCS20071; TSOT-23-5; MPN NCS20071SN2T1G; JLCPCB C457774

Connections:
+5V: C114.1, C117.2, C118.2, C120.2, D102.2 (K), FB102.1, U106.3 (OUT), U108.4 (V+), U108.5 (VL); also elsewhere on the board
+9V: C112.1, R112.2, U104.2 (VO), U106.1 (IN); also elsewhere on the board
+12V: C106.1, FB101.2, L101.2, Q101.2 (C), R105.1, U104.3 (VI), U110.5 (V+); also elsewhere on the board
-5V: C115.2, FB103.1, U107.3 (VO); also elsewhere on the board
-9V: C113.2, R114.2, U105.3 (VO), U107.2 (VI); also elsewhere on the board
-12V: C102.2, C107.2, C119.2, J101.2, J101.10, L102.2, Q102.2 (C), R106.2, RV101.3, U101.1 (REF), U101.4 (V-), U105.2 (VI), U108.7 (V-), U109.2 (V-), U110.2 (V-); also elsewhere on the board
/10MHZ_DIV: R107.1, R109.2, U103.2 (-)
/10MHZ_OUT+: J101.6, R104.1, R107.2
/10MHZ_OUT-: J101.7, R101.1
/AGC_MON: J101.5, TP115.1 (1_1); also elsewhere on the board
/AMPL_CTL: J101.11, TP117.1 (1_1)
/B+24V: C101.1, FB101.1, J101.1
/HEAT_MON: J101.3, TP113.1 (1_1); also elsewhere on the board
/Outputs/BUF: C108.1, C109.1, L103.1, R111.2; also elsewhere on the board
/PRE_N5V: C105.2, FB103.2, U103.4 (V-)
/PRE_P5V: C104.2, FB102.2, U103.7 (V+)
/Phase Noise/FREQ_CTL: D102.3 (COM), U101.3 (+); also elsewhere on the board
/SC10L_+5VREF: J101.8, RV101.1, TP116.1 (1_1); also elsewhere on the board
/SC10L_FREQ_CTL: C102.1, J101.9, R102.1, TP112.1 (1_1); also elsewhere on the board
/TEMP_CTL: J101.12, TP118.1 (1_1)
/VARAC_MON: J101.4, TP114.1 (1_1)
/~SIG_PRESENT: U108.6; also elsewhere on the board
GND: C101.2, C104.1, C105.1, C106.2, C107.1, C108.2, C109.2, C110.1, C111.1, C112.2, C113.1, C114.2, C115.1, C117.1, C118.1, C119.1, C120.1, D102.1 (A), H101.1 (1_1), H102.1 (1_1), H103.1 (1_1), H104.1 (1_1), H105.1 (1_1), H106.1 (1_1), H107.1 (1_1), H108.1 (1_1), H109.1 (1_1), H110.1 (1_1), H111.1 (1_1), H112.1 (1_1), H113.1 (1_1), H114.1 (1_1), H115.1 (1_1), L103.2, R101.2, R103.1, R104.2, R110.2, R113.2, R115.2, TP101.1 (1_1), TP102.1 (1_1), TP103.1 (1_1), TP104.1 (1_1), TP105.1 (1_1), TP106.1 (1_1), TP107.1 (1_1), TP108.1 (1_1), TP109.1 (1_1), TP110.1 (1_1), TP111.1 (1_1), U101.2 (-), U101.7 (V+), U103.3 (+), U106.2 (GND), U107.1 (GND), U108.3 (GND), U109.5 (V+); also elsewhere on the board
unnamed: D101.2 (A), J102.2, L102.1
unnamed: D101.1 (K), J102.1, L101.1
unnamed: C103.2, Q101.1 (B), Q102.1 (B), R108.2, U110.1
unnamed: Q101.3 (E), Q102.3 (E), R108.1, R110.1
unnamed: R102.2, U108.1
unnamed: R109.1, R111.1, U103.6
unnamed: R116.2, U108.8
unnamed: U101.5 (SENSE), U101.6, U108.2
unnamed: C110.2, R112.1, R113.1, U104.1 (ADJ)
unnamed: C111.2, R114.1, R115.1, U105.1 (ADJ)
unnamed: RV101.2, U109.3 (+)
unnamed: R116.1, U109.1, U109.4 (-)
unnamed: R105.2, R106.1, U110.3 (+)
unnamed: C103.1, R103.2, U110.4 (-)

Notes on the sheet:
SC10L_GND
WHEN EXT 10 MHz NOT PRESENT, DISCONNECT EFC AND USE MANUAL ADJUST
ESTIMATED MAX CURRENT DRAW ========================== RAIL CURRENT POWER NOTES +12 V 0.52 A 6.24 W OCXO PLUS ALL POSITIVE-RAIL LOADS −12 V 0.52 A 6.24 W RETURN CURRENT OF THE FLOATING 24 V SUPPLY +9 V 0.31 A 2.79 W +5 V REG PLUS +9 V LOADS −9 V 0.24 A 2.16 W −5 V REG PLUS −9 V LOADS +5 V 0.21 A 1.0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
FEMALE HEADER TO SC10L ADAPTER BOARD
CURRENT BALANCE TO SPLIT SINGLE SUPPLY
(POT ON SEPARATE PCB)
POLARITY PROTECTION
UNIVERSAL INPUT / FLOATING OUTPUT 24 V / 1.50 A SWITCHING POWER SUPPLY MEANWELL PART NUMBER EPS-35-24
CLAMP TO RANGE (−0.25, +5.25) V

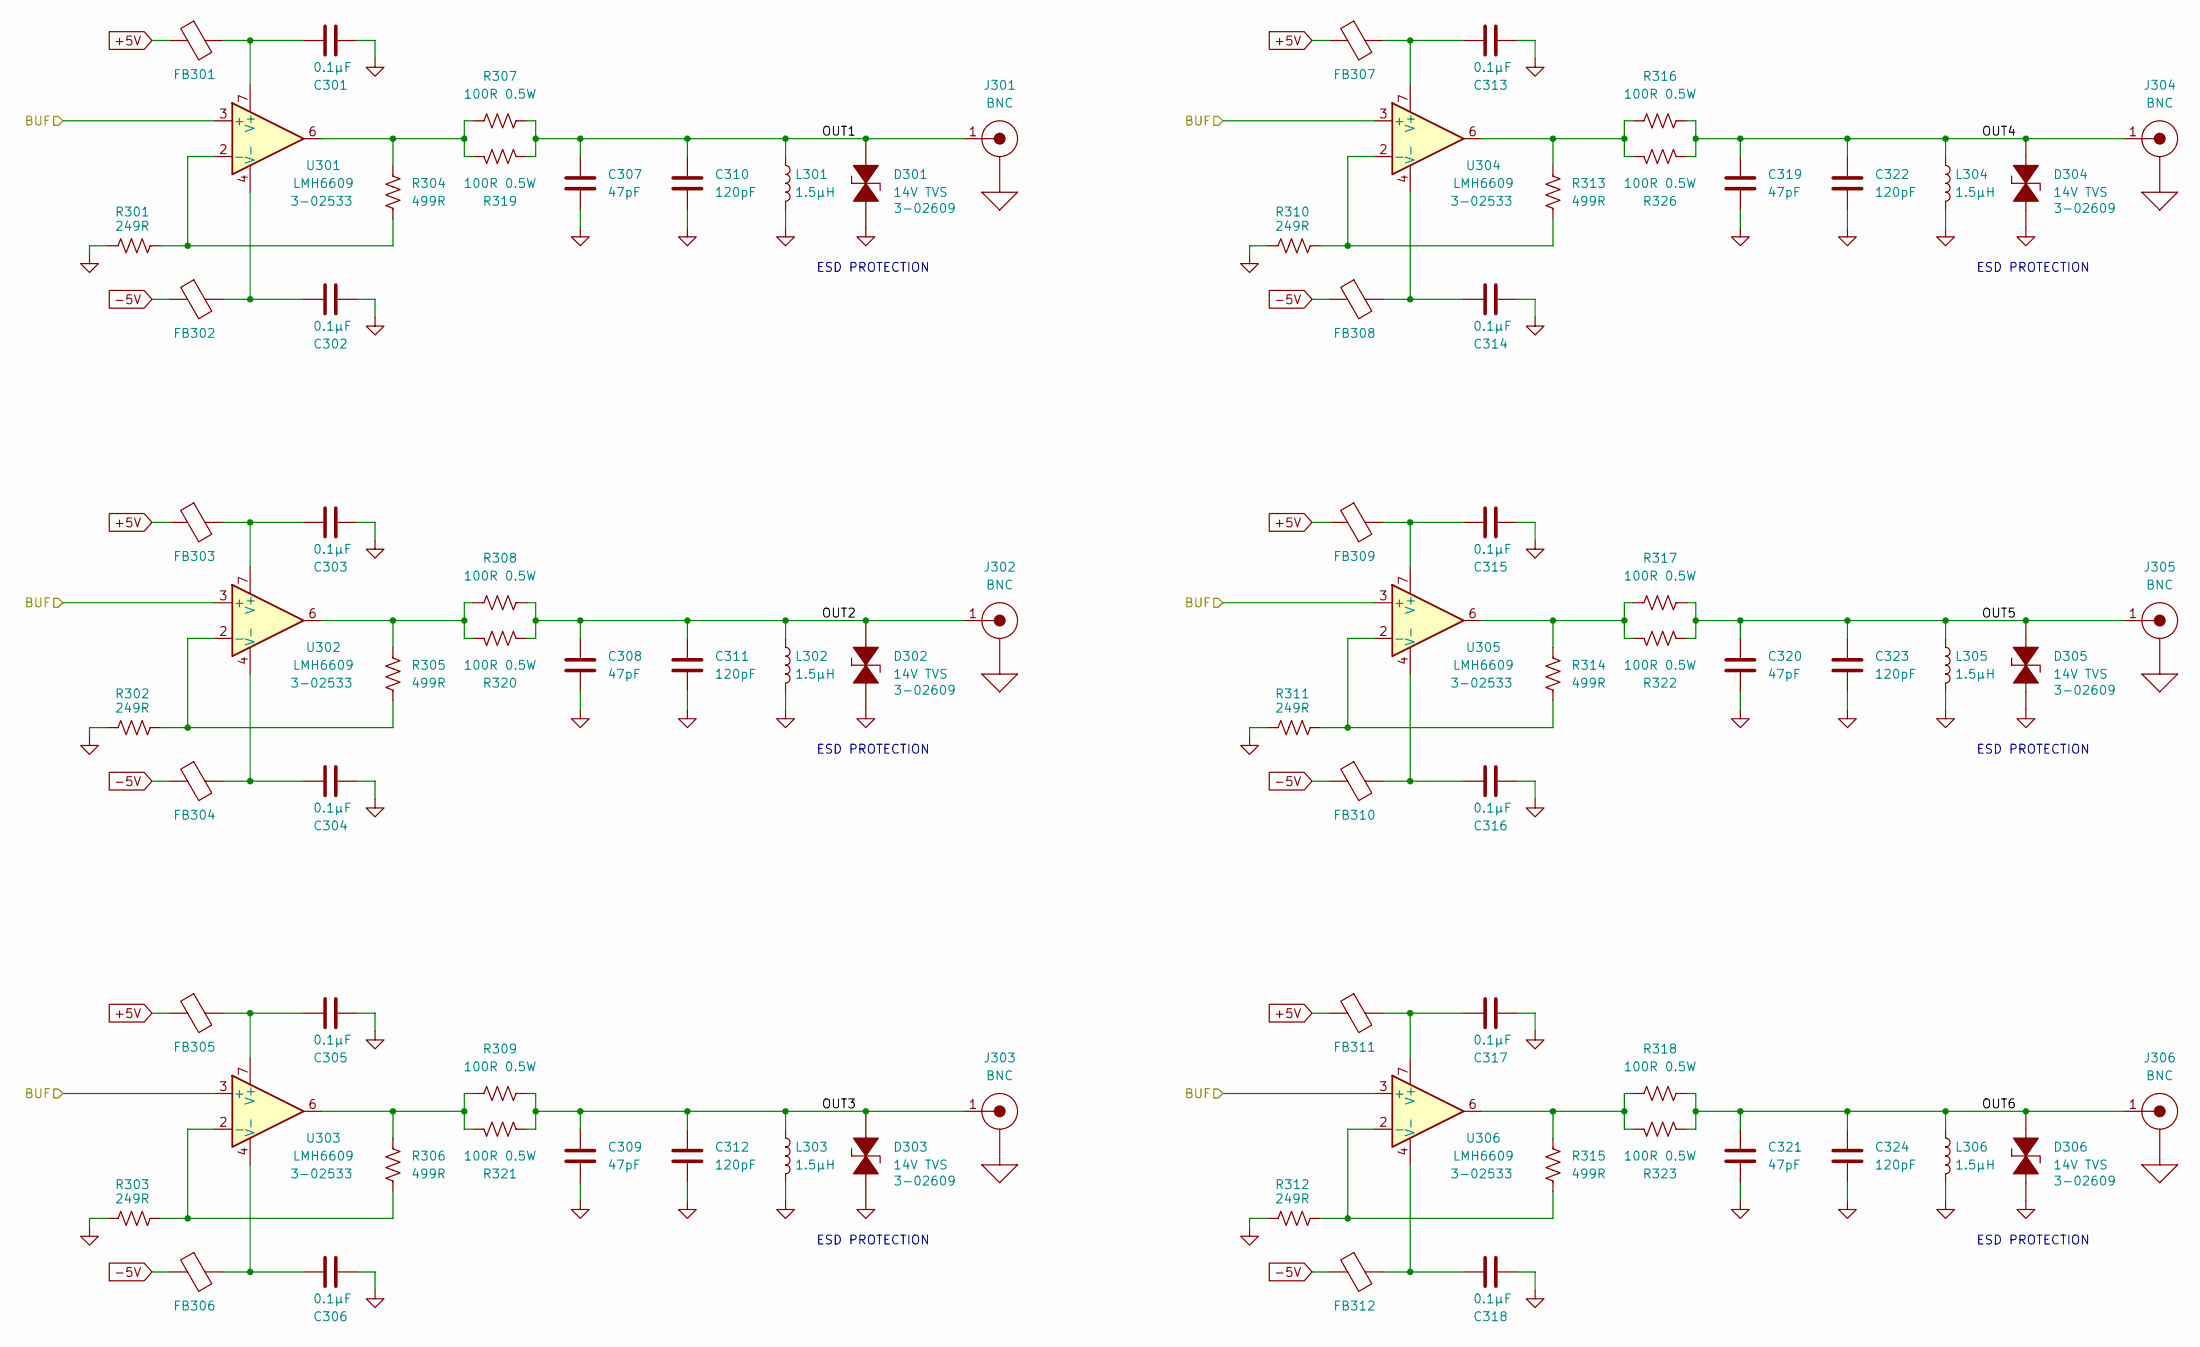
[picture p29: schematic out.kicad_sch, ${TITLE}]

Parts:
C301, C302, C303, C304, C305, C306, C313, C314, C315, C316, C317, C318: 0.1μF; C_0603_1608Metric; Voltage 50V; MPN 06035C104KAT4A; JLCPCB C14663
C307, C308, C309, C319, C320, C321: 47pF; C_0603_1608Metric; Voltage 50V; MPN C0603C470J5GACTU; JLCPCB C2167347
C310, C311, C312, C322, C323, C324: 120pF; C_0603_1608Metric; Voltage 50V; MPN C0603C121J5GACTU; JLCPCB C2168575
D301, D302, D303, D304, D305, D306: 14V TVS; C_0402_1005Metric; MPN PESD0402-140; JLCPCB C7473167
FB301, FB302, FB303, FB304, FB305, FB306, FB307, FB308, FB309, FB310, FB311, FB312: 742863160; L_0603_1608Metric; MPN 742863160; JLCPCB C2650942
J301, J302, J303, J304, J305, J306: BNC; BNC-STRIP; MPN 73100-0195; JLCPCB --
L301, L302, L303, L304, L305, L306: 1.5μH; L_0805_2012Metric; MPN MLF2012A1R5JTD25; JLCPCB C139220
R301, R302, R303, R310, R311, R312: 249R; R_0603_1608Metric; MPN TFCR0603-16W-E-2490FT; JLCPCB C22919
R304, R305, R306, R313, R314, R315: 499R; R_0603_1608Metric; MPN TFCR0603-16W-E-4990FT; JLCPCB C23065
R307, R308, R309, R316, R317, R318, R319, R320, R321, R322, R323, R326: 100R 0.5W; R_1206_3216Metric; MPN RNCP1206FTD100R; JLCPCB C2441432
U301, U302, U303, U304, U305, U306: LMH6609; SO-8_3.9x4.9mm_P1.27mm; MPN LMH6609MAX/NOPB; JLCPCB C2060005

Connections:
+5V: FB301.1, FB303.1, FB305.1, FB307.1, FB309.1, FB311.1; also elsewhere on the board
-5V: FB302.1, FB304.1, FB306.1, FB308.1, FB310.1, FB312.1; also elsewhere on the board
/Outputs/BUF: U301.3 (+), U302.3 (+), U303.3 (+), U304.3 (+), U305.3 (+), U306.3 (+); also elsewhere on the board
/Outputs/OUT1: C307.1, C310.1, D301.1 (CATHODE), J301.1 (C_1), L301.1, R307.2, R319.2
/Outputs/OUT2: C308.1, C311.1, D302.1 (CATHODE), J302.1 (C_1), L302.1, R308.2, R320.2
/Outputs/OUT3: C309.1, C312.1, D303.1 (CATHODE), J303.1 (C_1), L303.1, R309.2, R321.2
/Outputs/OUT4: C319.1, C322.1, D304.1 (CATHODE), J304.1 (C_1), L304.1, R316.2, R326.2
/Outputs/OUT5: C320.1, C323.1, D305.1 (CATHODE), J305.1 (C_1), L305.1, R317.2, R322.2
/Outputs/OUT6: C321.1, C324.1, D306.1 (CATHODE), J306.1 (C_1), L306.1, R318.2, R323.2
GND: C301.1, C302.1, C303.1, C304.1, C305.1, C306.1, C307.2, C308.2, C309.2, C310.2, C311.2, C312.2, C313.1, C314.1, C315.1, C316.1, C317.1, C318.1, C319.2, C320.2, C321.2, C322.2, C323.2, C324.2, D301.2 (ANODE), D302.2 (ANODE), D303.2 (ANODE), D304.2 (ANODE), D305.2 (ANODE), D306.2 (ANODE), L301.2, L302.2, L303.2, L304.2, L305.2, L306.2, R301.2, R302.2, R303.2, R310.2, R311.2, R312.2; also elsewhere on the board
unnamed: R304.1, R307.1, R319.1, U301.6
unnamed: R305.1, R308.1, R320.1, U302.6
unnamed: R306.1, R309.1, R321.1, U303.6
unnamed: R313.1, R316.1, R326.1, U304.6
unnamed: R314.1, R317.1, R322.1, U305.6
unnamed: R315.1, R318.1, R323.1, U306.6
unnamed: R301.1, R304.2, U301.2 (-)
unnamed: C301.2, FB301.2, U301.7 (V+)
unnamed: C302.2, FB302.2, U301.4 (V-)
unnamed: R302.1, R305.2, U302.2 (-)
unnamed: C303.2, FB303.2, U302.7 (V+)
unnamed: C304.2, FB304.2, U302.4 (V-)
unnamed: R303.1, R306.2, U303.2 (-)
unnamed: C305.2, FB305.2, U303.7 (V+)
unnamed: C306.2, FB306.2, U303.4 (V-)
unnamed: R310.1, R313.2, U304.2 (-)
unnamed: C313.2, FB307.2, U304.7 (V+)
unnamed: C314.2, FB308.2, U304.4 (V-)
unnamed: R311.1, R314.2, U305.2 (-)
unnamed: C315.2, FB309.2, U305.7 (V+)
unnamed: C316.2, FB310.2, U305.4 (V-)
unnamed: R312.1, R315.2, U306.2 (-)
unnamed: C317.2, FB311.2, U306.7 (V+)
unnamed: C318.2, FB312.2, U306.4 (V-)

Notes on the sheet:
ESD PROTECTION

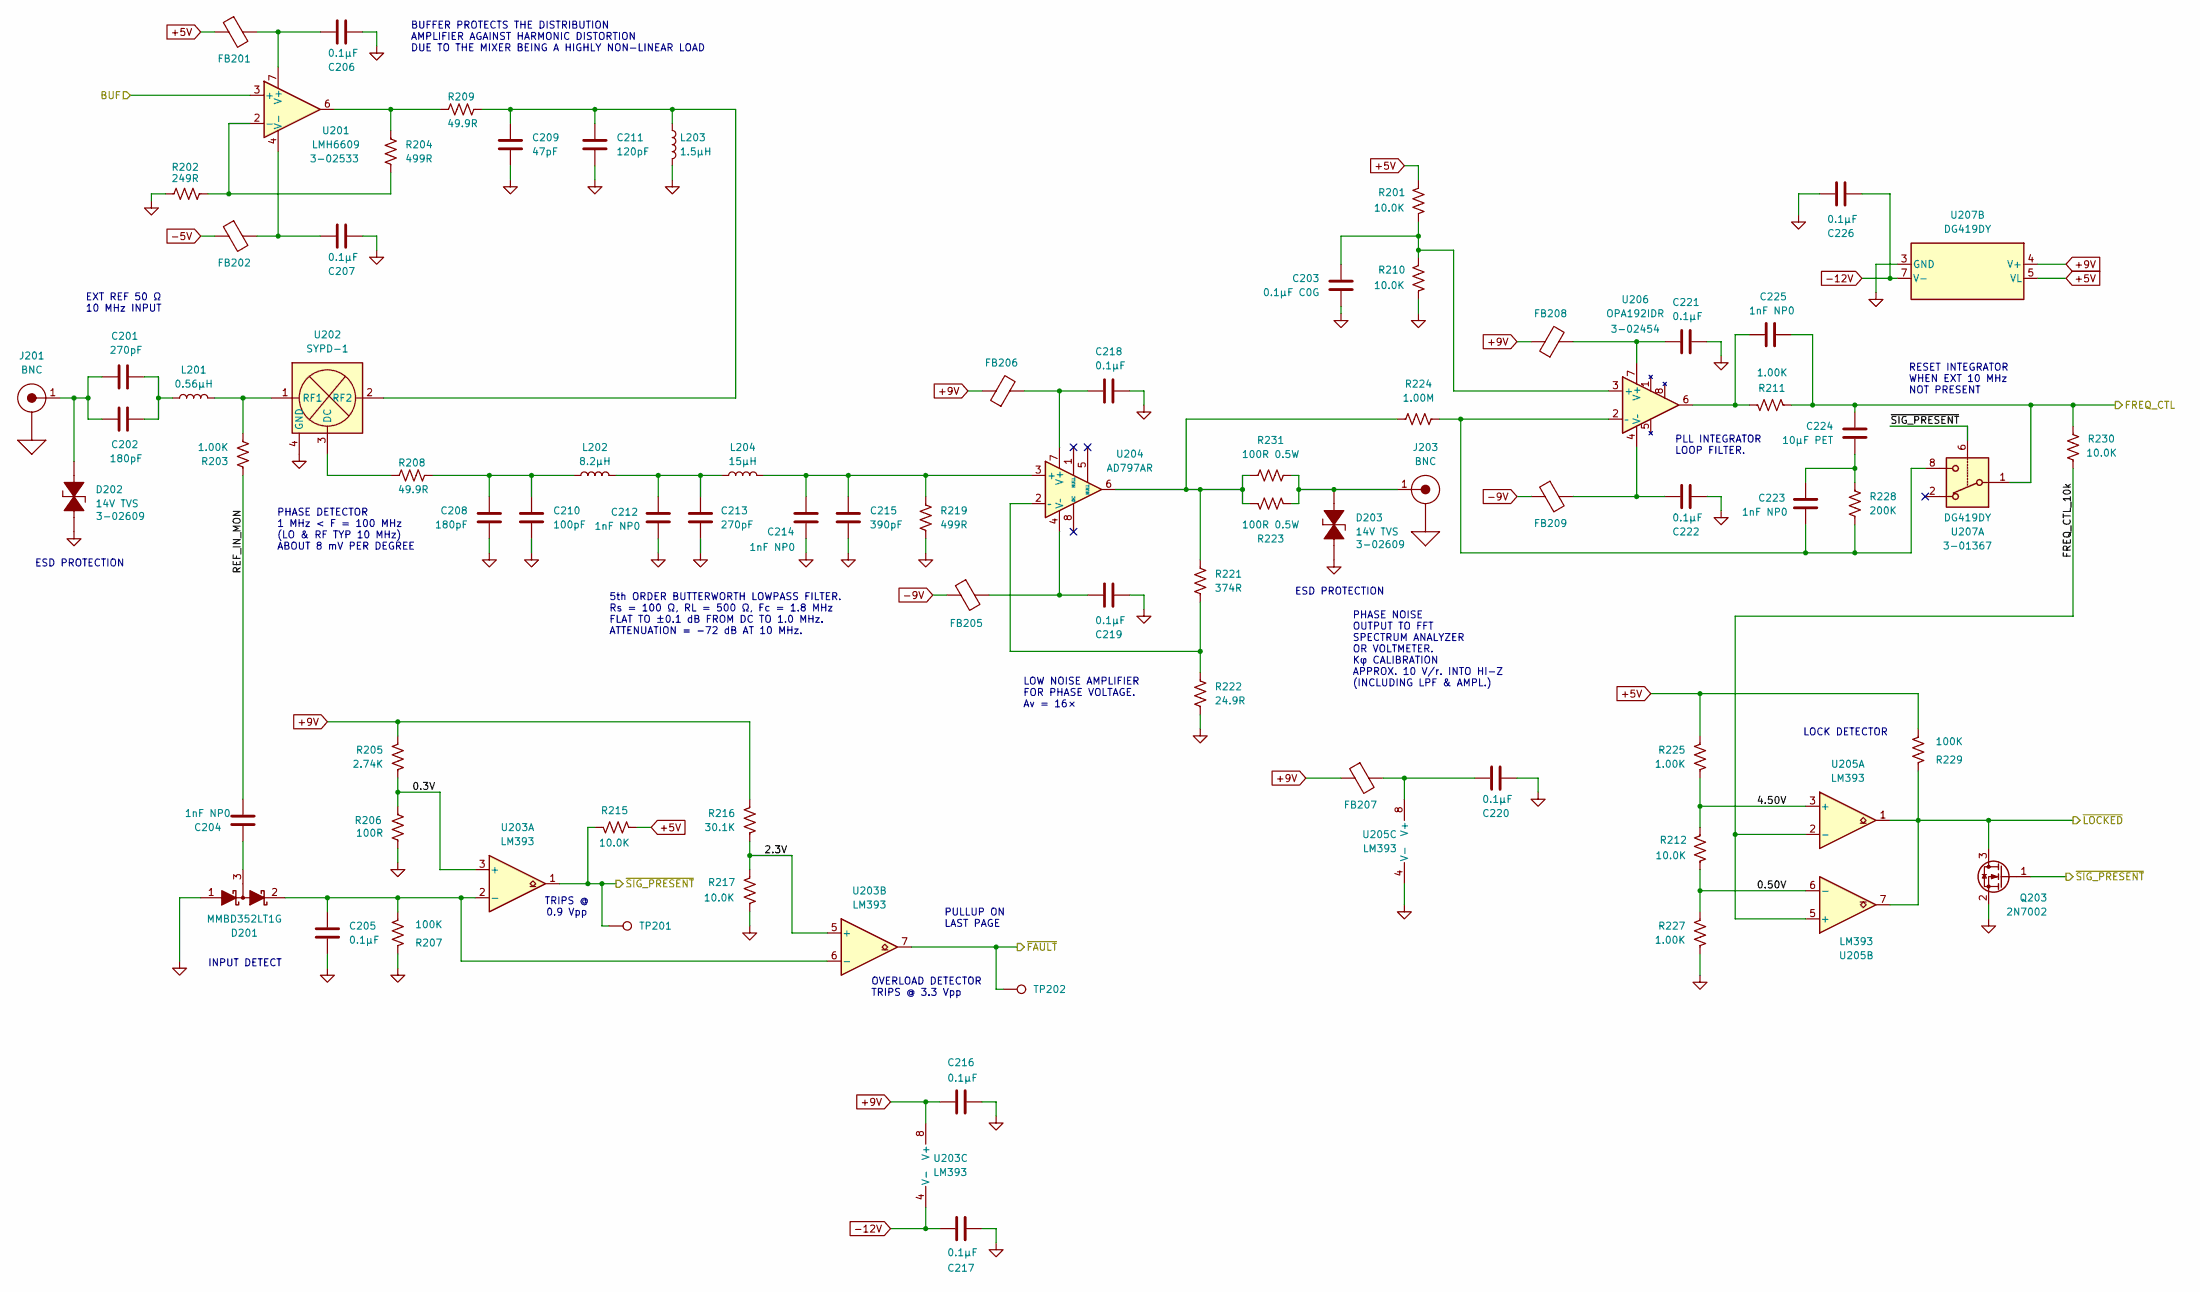
[picture p30: schematic pn.kicad_sch, ${TITLE}]

Parts:
C201, C213: 270pF; C_0603_1608Metric; Voltage 50V; MPN C0603C271J5GACTU; JLCPCB C49326315
C202, C208: 180pF; C_1206_3216Metric; Voltage 50V; MPN C1206C181J5GACTU; JLCPCB C541494
C203: 0.1μF C0G; C_1206_3216Metric; Voltage 50V; MPN GRT31C5C1H104FA02L; JLCPCB C3839854
C204, C212, C214, C223, C225: 1nF NP0; C_0603_1608Metric; Voltage 50V; MPN C0603C102J5GACTU; JLCPCB C2181873
C205, C206, C207, C216, C217, C218, C219, C220, C221, C222, C226: 0.1μF; C_0603_1608Metric; Voltage 50V; MPN 06035C104KAT4A; JLCPCB C14663
C209: 47pF; C_0603_1608Metric; Voltage 50V; MPN C0603C470J5GACTU; JLCPCB C2167347
C210: 100pF; C_0603_1608Metric; Voltage 50V; MPN C0603C101J5GACTU; JLCPCB C2167328
C211: 120pF; C_0603_1608Metric; Voltage 50V; MPN C0603C121J5GACTU; JLCPCB C2168575
C215: 390pF; C_0603_1608Metric; Voltage 50V; MPN C0603C391J5GACTU; JLCPCB C22408867
C224: 10μF PET; C_Rect_L18.0mm_W9.0mm_P15.00mm_FKS3_FKP3; Voltage 63V; MPN B32522C0106K189; JLCPCB C3769153
D201: MMBD352LT1G; SOT-23; MPN MMBD352LT1G; JLCPCB C463549
D202, D203: 14V TVS; C_0402_1005Metric; MPN PESD0402-140; JLCPCB C7473167
FB201, FB202, FB205, FB206, FB207, FB208, FB209: 742863160; L_0603_1608Metric; MPN 742863160; JLCPCB C2650942
J201, J203: BNC; BNC-STRIP; MPN 73100-0195; JLCPCB --
L201: 0.56μH; L_1210_3225Metric; MPN 1206CS-561XJRC; JLCPCB C318049
L202: 8.2μH; L_1206_3216Metric; MPN AIML-1206-8R2K-T; JLCPCB C51018442
L203: 1.5μH; L_0805_2012Metric; MPN MLF2012A1R5JTD25; JLCPCB C139220
L204: 15μH; L_0805_2012Metric; MPN MLF2012C150K; JLCPCB C383402
Q203: 2N7002; SOT-23; MPN 2N7002H6327XTSA2; JLCPCB C8545
R201, R210, R212, R215, R217, R230: 10.0K; R_0603_1608Metric; MPN TFCR0603-16W-E-1002FT; JLCPCB C98220
R202: 249R; R_0603_1608Metric; MPN TFCR0603-16W-E-2490FT; JLCPCB C22919
R203, R211, R225, R227: 1.00K; R_0603_1608Metric; MPN RR0816P-102-D; JLCPCB C22548
R204, R219: 499R; R_0603_1608Metric; MPN TFCR0603-16W-E-4990FT; JLCPCB C23065
R205: 2.74K; R_0603_1608Metric; MPN TFCR0603-16W-E-2741FT; JLCPCB C2930073
R206: 100R; R_0603_1608Metric; MPN RR0816P-101-D; JLCPCB C22775
R207, R229: 100K; R_0603_1608Metric; MPN TFCR0603-16W-E-1003FT; JLCPCB C25803
R208, R209: 49.9R; R_0603_1608Metric; MPN TFCR0603-16W-E-49R9FT; JLCPCB C23185
R216: 30.1K; R_0603_1608Metric; MPN RR0816P-3012-D-47C; JLCPCB C23000
R221: 374R; R_0603_1608Metric; MPN TFCR0603-16W-E-3740F; JLCPCB C3981304
R222: 24.9R; R_0603_1608Metric; MPN TFCR0603-16W-E-24R9FT; JLCPCB C22916
R223, R231: 100R 0.5W; R_1206_3216Metric; MPN RNCP1206FTD100R; JLCPCB C2441432
R224: 1.00M; R_0603_1608Metric; MPN RMCF0603FT1M00; JLCPCB C22935
R228: 200K; R_0603_1608Metric; MPN TFCR0603-16W-E-2003FT; JLCPCB C25811
TP201, TP202: TestPoint; TestPoint_THTPad_D1.0mm_Drill0.5mm; MPN --; JLCPCB --
U201: LMH6609; SO-8_3.9x4.9mm_P1.27mm; MPN LMH6609MAX/NOPB; JLCPCB C2060005
U202: SYPD-1; Mini-Circuits_TTT167_LandPatternPL-079; MPN SYPD-1+; JLCPCB C5368969
U203, U205: LM393; SO-8_3.9x4.9mm_P1.27mm; MPN LM393DR; JLCPCB C67470
U204: AD797AR; SO-8_3.9x4.9mm_P1.27mm; MPN AD797ARZ; JLCPCB C578574
U206: OPA192IDR; SOIC-8_3.9x4.9mm_P1.27mm; MPN OPA192IDR; JLCPCB C2861286
U207: DG419DY; SO-8_3.9x4.9mm_P1.27mm; MPN DG419DY-T1-E3; JLCPCB C6581

Connections:
+5V: FB201.1, R201.2, R215.2, R225.2, R229.2, U207.5 (VL); also elsewhere on the board
+9V: C216.2, FB206.1, FB207.1, FB208.1, R205.1, R216.2, U203.8 (V+), U207.4 (V+); also elsewhere on the board
-5V: FB202.1; also elsewhere on the board
-9V: FB205.1, FB209.1; also elsewhere on the board
-12V: C217.2, C226.1, U203.4 (V-), U207.7 (V-); also elsewhere on the board
/Outputs/BUF: U201.3 (+); also elsewhere on the board
/Phase Noise/0.3V: R205.2, R206.1, U203.3 (+)
/Phase Noise/0.50V: R212.1, R227.2, U205.6 (-)
/Phase Noise/2.3V: R216.1, R217.2, U203.5 (+)
/Phase Noise/4.50V: R212.2, R225.1, U205.3 (+)
/Phase Noise/FREQ_CTL: C224.1, C225.1, R211.2, R230.2, U207.1; also elsewhere on the board
/Phase Noise/FREQ_CTL_10k: R230.1, U205.2 (-), U205.5 (+)
/Phase Noise/REF_IN_MON: C204.1, R203.2
/~FAULT: TP202.1 (1_1), U203.7; also elsewhere on the board
/~LOCKED: Q203.3 (D), R229.1, U205.1, U205.7; also elsewhere on the board
/~SIG_PRESENT: Q203.1 (G), R215.1, TP201.1 (1_1), U203.1, U207.6; also elsewhere on the board
GND: C203.2, C205.1, C206.1, C207.1, C208.2, C209.2, C210.2, C211.2, C212.1, C213.2, C214.1, C215.2, C216.1, C217.1, C218.1, C219.1, C220.1, C221.1, C222.1, C226.2, D201.1 (A), D202.2 (ANODE), D203.2 (ANODE), L203.2, Q203.2 (S), R202.2, R206.2, R207.1, R210.1, R217.1, R219.1, R222.2, R227.1, U202.4 (GND), U202.5 (GND), U202.6 (GND), U205.4 (V-), U207.3 (GND); also elsewhere on the board
unnamed: C201.2, C202.2, L201.1
unnamed: C208.1, C210.1, L202.1, R208.2
unnamed: C212.2, C213.1, L202.2, L204.1
unnamed: C223.2, C224.2, R228.1
unnamed: C225.2, R211.1, U206.6
unnamed: C204.2, D201.3 (COM)
unnamed: C205.2, D201.2 (K), R207.2, U203.2 (-), U203.6 (-)
unnamed: C201.1, C202.1, D202.1 (CATHODE), J201.1 (C_1)
unnamed: D203.1 (CATHODE), J203.1 (C_1), R223.2, R231.2
unnamed: R204.1, R209.1, U201.6
unnamed: R221.1, R223.1, R224.1, R231.1, U204.6
unnamed: R202.1, R204.2, U201.2 (-)
unnamed: C206.2, FB201.2, U201.7 (V+)
unnamed: C207.2, FB202.2, U201.4 (V-)
unnamed: R208.1, U202.3 (DC)
unnamed: L201.2, R203.1, U202.1 (RF1)
unnamed: C209.1, C211.1, L203.1, R209.2, U202.2 (RF2)
unnamed: C214.2, C215.1, L204.2, R219.2, U204.3 (+)
unnamed: C218.2, FB206.2, U204.7 (V+)
unnamed: C219.2, FB205.2, U204.4 (V–)
unnamed: R221.2, R222.1, U204.2 (–)
unnamed: C220.2, FB207.2, U205.8 (V+)
unnamed: C203.1, R201.1, R210.2, U206.3 (+)
unnamed: C221.2, FB208.2, U206.7 (V+)
unnamed: C222.2, FB209.2, U206.4 (V–)
unnamed: C223.1, R224.2, R228.2, U206.2 (–), U207.8

Notes on the sheet:
RESET INTEGRATOR WHEN EXT 10 MHz NOT PRESENT
5th ORDER BUTTERWORTH LOWPASS FILTER. Rs = 100 Ω, RL = 500 Ω, Fc = 1.8 MHz FLAT TO ±0.1 dB FROM DC TO 1.0 MHz. ATTENUATION = -72 dB AT 10 MHz.
PHASE DETECTOR 1 MHz < F = 100 MHz (LO & RF TYP 10 MHz) ABOUT 8 mV PER DEGREE
PULLUP ON LAST PAGE
ESD PROTECTION
TRIPS @ 0.9 Vpp
EXT REF 50 Ω 10 MHz INPUT
PHASE NOISE OUTPUT TO FFT SPECTRUM ANALYZER OR VOLTMETER. Kφ CALIBRATION APPROX. 10 V/r. INTO HI-Z (INCLUDING LPF & AMPL.)
INPUT DETECT
BUFFER PROTECTS THE DISTRIBUTION AMPLIFIER AGAINST HARMONIC DISTORTION DUE TO THE MIXER BEING A HIGHLY NON-LINEAR LOAD
LOW NOISE AMPLIFIER FOR PHASE VOLTAGE. Av = 16×
OVERLOAD DETECTOR TRIPS @ 3.3 Vpp
PLL INTEGRATOR LOOP FILTER.
LOCK DETECTOR
