js214/FS720_layout/motherboard/fs.kicad_pcb

## KiCad design motherboard/fs.kicad_pcb (continued)

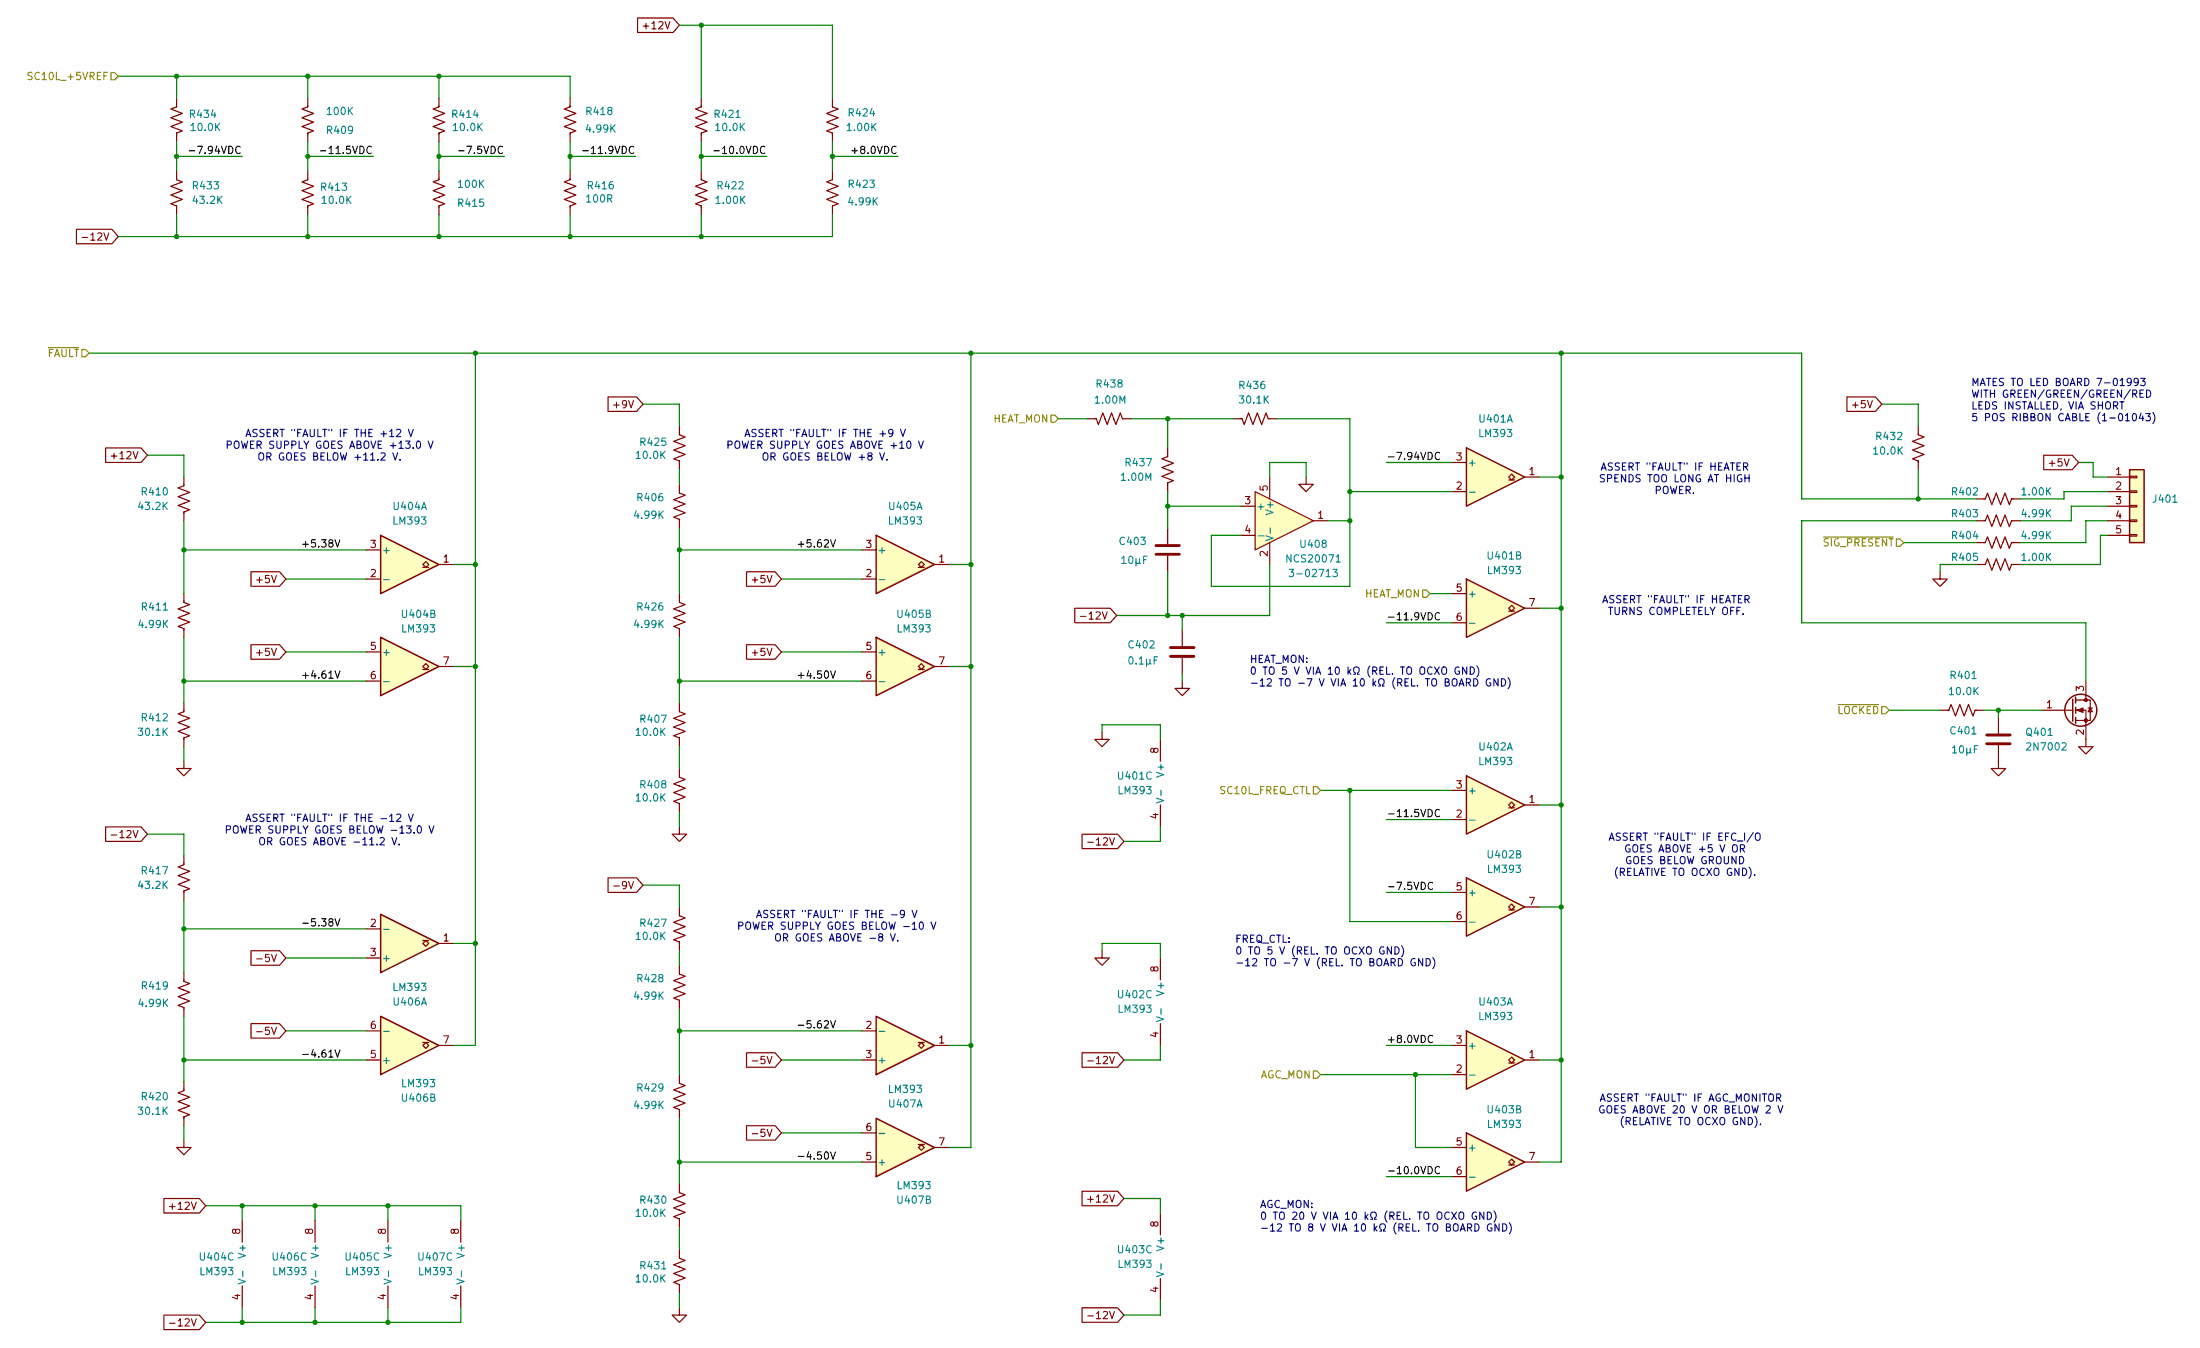
[picture p31: schematic fp.kicad_sch, ${TITLE}]

Parts:
C401, C403: 10μF; C_0805_2012Metric; Voltage 25V; MPN GRM21BR61E106KA73L; JLCPCB C84416
C402: 0.1μF; C_0603_1608Metric; Voltage 50V; MPN 06035C104KAT4A; JLCPCB C14663
J401: Conn_01x05; PinHeader_1x05_P2.54mm_Vertical; MPN --; JLCPCB --
Q401: 2N7002; SOT-23; MPN 2N7002H6327XTSA2; JLCPCB C8545
R401, R407, R408, R413, R414, R421, R425, R427, R430, R431, R432, R434: 10.0K; R_0603_1608Metric; MPN TFCR0603-16W-E-1002FT; JLCPCB C98220
R402, R405, R422, R424: 1.00K; R_0603_1608Metric; MPN RR0816P-102-D; JLCPCB C22548
R403, R404, R406, R411, R418, R419, R423, R426, R428, R429: 4.99K; R_0603_1608Metric; MPN TFCR0603-16W-E-4991FT; JLCPCB C23046
R409, R415: 100K; R_0603_1608Metric; MPN TFCR0603-16W-E-1003FT; JLCPCB C25803
R410, R417, R433: 43.2K; R_0603_1608Metric; MPN TNPW060343K2BEEA; JLCPCB C23053
R412, R420, R436: 30.1K; R_0603_1608Metric; MPN RR0816P-3012-D-47C; JLCPCB C23000
R416: 100R; R_0603_1608Metric; MPN RR0816P-101-D; JLCPCB C22775
R437, R438: 1.00M; R_0603_1608Metric; MPN RMCF0603FT1M00; JLCPCB C22935
U401, U402, U403, U404, U405, U406, U407: LM393; SO-8_3.9x4.9mm_P1.27mm; MPN LM393DR; JLCPCB C67470
U408: NCS20071; TSOT-23-5; MPN NCS20071SN2T1G; JLCPCB C457774

Connections:
+5V: J401.1, R432.1, U404.2 (-), U404.5 (+), U405.2 (-), U405.5 (+); also elsewhere on the board
+9V: R425.1; also elsewhere on the board
+12V: R410.2, R421.1, R424.2, U403.8 (V+), U404.8 (V+), U405.8 (V+), U406.8 (V+), U407.8 (V+); also elsewhere on the board
-5V: U406.3 (+), U406.6 (-), U407.3 (+), U407.6 (-); also elsewhere on the board
-9V: R427.1; also elsewhere on the board
-12V: C402.1, C403.2, R413.2, R415.1, R416.2, R417.2, R422.1, R423.1, R433.1, U401.4 (V-), U402.4 (V-), U403.4 (V-), U404.4 (V-), U405.4 (V-), U406.4 (V-), U407.4 (V-), U408.2 (V-); also elsewhere on the board
/AGC_MON: U403.2 (-), U403.5 (+); also elsewhere on the board
/Front Panel/+4.50V: R407.1, R426.1, U405.6 (-)
/Front Panel/+4.61V: R411.1, R412.2, U404.6 (-)
/Front Panel/+5.38V: R410.1, R411.2, U404.3 (+)
/Front Panel/+5.62V: R406.1, R426.2, U405.3 (+)
/Front Panel/+8.0VDC: R423.2, R424.1, U403.3 (+)
/Front Panel/-4.50V: R429.1, R430.1, U407.5 (+)
/Front Panel/-4.61V: R419.1, R420.2, U406.5 (+)
/Front Panel/-5.38V: R417.1, R419.2, U406.2 (-)
/Front Panel/-5.62V: R428.1, R429.2, U407.2 (-)
/Front Panel/-7.5VDC: R414.2, R415.2, U402.5 (+)
/Front Panel/-7.94VDC: R433.2, R434.2, U401.3 (+)
/Front Panel/-10.0VDC: R421.2, R422.2, U403.6 (-)
/Front Panel/-11.5VDC: R409.1, R413.1, U402.2 (-)
/Front Panel/-11.9VDC: R416.1, R418.1, U401.6 (-)
/HEAT_MON: R438.2, U401.5 (+); also elsewhere on the board
/SC10L_+5VREF: R409.2, R414.1, R418.2, R434.1; also elsewhere on the board
/SC10L_FREQ_CTL: U402.3 (+), U402.6 (-); also elsewhere on the board
/~FAULT: R402.1, R432.2, U401.1, U401.7, U402.1, U402.7, U403.1, U403.7, U404.1, U404.7, U405.1, U405.7, U406.1, U406.7, U407.1, U407.7; also elsewhere on the board
/~LOCKED: R401.1; also elsewhere on the board
/~SIG_PRESENT: R404.1; also elsewhere on the board
GND: C401.2, C402.2, Q401.2 (S), R405.1, R408.2, R412.1, R420.1, R431.2, U401.8 (V+), U402.8 (V+), U408.5 (V+); also elsewhere on the board
unnamed: J401.2, R402.2
unnamed: J401.3, R403.2
unnamed: J401.4, R404.2
unnamed: J401.5, R405.2
unnamed: Q401.3 (D), R403.1
unnamed: C401.1, Q401.1 (G), R401.2
unnamed: R406.2, R425.2
unnamed: R407.2, R408.1
unnamed: R427.2, R428.2
unnamed: R430.2, R431.1
unnamed: R436.1, R437.2, R438.1
unnamed: R436.2, U401.2 (-), U408.1, U408.4 (-)
unnamed: C403.1, R437.1, U408.3 (+)

Notes on the sheet:
ASSERT "FAULT" IF THE -12 V POWER SUPPLY GOES BELOW -13.0 V OR GOES ABOVE -11.2 V.
AGC_MON: 0 TO 20 V VIA 10 kΩ (REL. TO OCXO GND) -12 TO 8 V VIA 10 kΩ (REL. TO BOARD GND)
ASSERT "FAULT" IF EFC_I/O GOES ABOVE +5 V OR GOES BELOW GROUND (RELATIVE TO OCXO GND).
ASSERT "FAULT" IF THE +12 V POWER SUPPLY GOES ABOVE +13.0 V OR GOES BELOW +11.2 V.
ASSERT "FAULT" IF THE -9 V POWER SUPPLY GOES BELOW -10 V OR GOES ABOVE -8 V.
HEAT_MON: 0 TO 5 V VIA 10 kΩ (REL. TO OCXO GND) -12 TO -7 V VIA 10 kΩ (REL. TO BOARD GND)
ASSERT "FAULT" IF HEATER SPENDS TOO LONG AT HIGH POWER.
ASSERT "FAULT" IF THE +9 V POWER SUPPLY GOES ABOVE +10 V OR GOES BELOW +8 V.
ASSERT "FAULT" IF HEATER TURNS COMPLETELY OFF.
FREQ_CTL: 0 TO 5 V (REL. TO OCXO GND) -12 TO -7 V (REL. TO BOARD GND)
MATES TO LED BOARD 7-01993 WITH GREEN/GREEN/GREEN/RED LEDS INSTALLED, VIA SHORT 5 POS RIBBON CABLE (1-01043)
ASSERT "FAULT" IF AGC_MONITOR GOES ABOVE 20 V OR BELOW 2 V (RELATIVE TO OCXO GND).

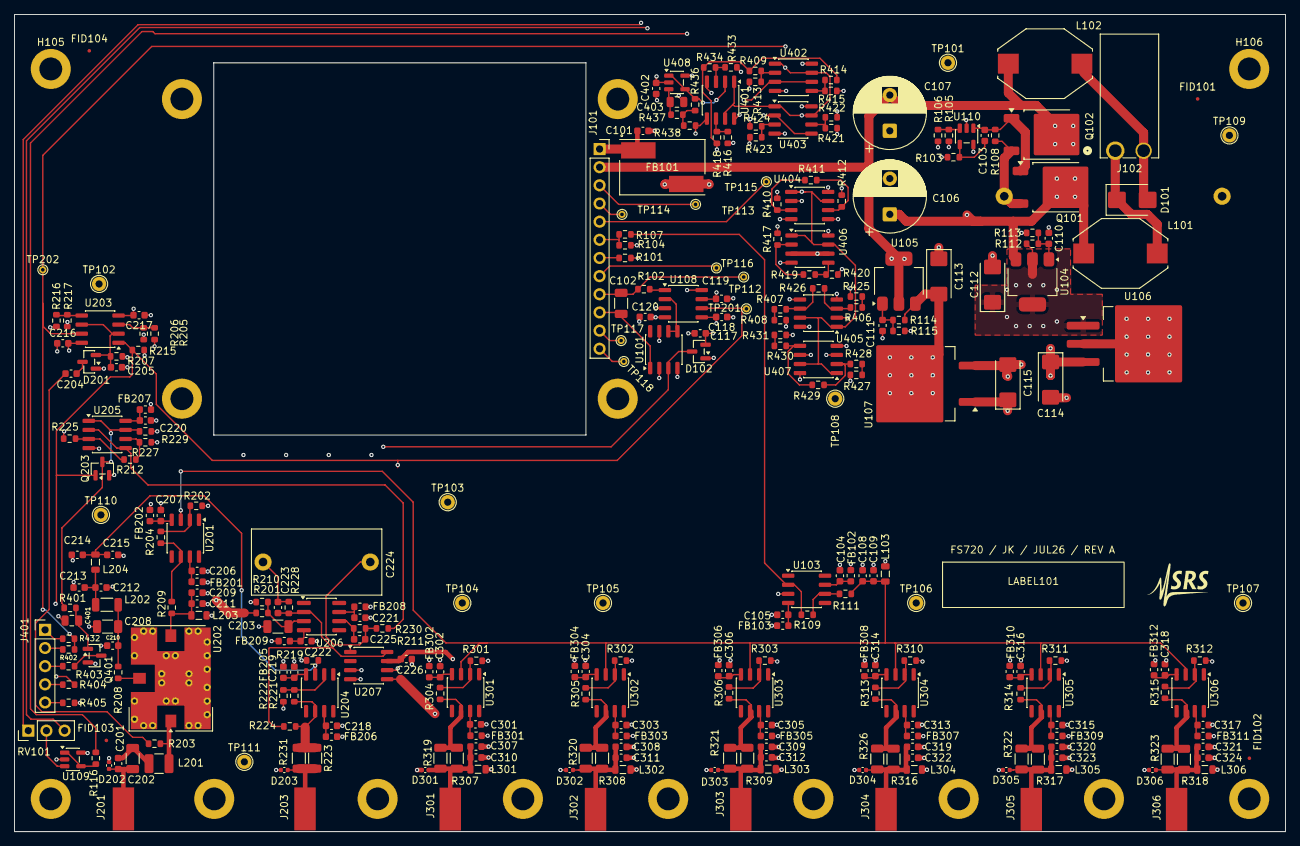
[picture p32: board fs.kicad_pcb from above]

Board: 6 copper layers, 177.8 x 114.3 mm, 307 parts (1 on the bottom side), 128 nets.
