js214/FS720_layout/(commit log)

2026-07-24 use SOIC-8 for OPA192IDR
    [fs.kicad_pcb, pn.kicad_sch]
2026-07-24 remove stale files
    [bom.csv]
2026-07-24 fix ERC issues
    [fs.kicad_pcb, fs.kicad_sch, pn.kicad_sch]
2026-07-24 add ESD protection (14V TVS)
    [fs.kicad_pcb, fs.kicad_sch, out.kicad_sch, pn.kicad_sch]
2026-07-24 add mechanical parts to bom
    [fs.kicad_sch, ocxo_mount.kicad_pcb, ocxo_mount.kicad_sch]
2026-07-24 add schematic annotations
    [fs.kicad_sch, pn.kicad_sch]
2026-07-25 retune comparator thresholds for 1--3 Vpp
    [fs.kicad_pcb, pn.kicad_sch]
2026-07-27 update OCXO bead to SMB2.5R-2 (higher current)
    [fs.kicad_pcb, fs.kicad_sch, out.kicad_sch, pn.kicad_sch]
2026-07-27 add fab notes
    [fs.kicad_pcb]
2026-07-27 add testpoints
    [fs.kicad_pcb, fs.kicad_sch, pn.kicad_sch]
2026-07-27 update bead value for ocxo power
    [fs.kicad_pcb, fs.kicad_sch]
2026-07-27 move fab notes to text file
    [fs.kicad_pcb]
2026-07-27 set Solder mask minimum web width
    [fs.kicad_pcb]
2026-07-27 fix annotations
    [fs.kicad_pcb, ocxo_mount.kicad_pcb, ocxo_mount.kicad_sch, pn.kicad_sch]
2026-07-27 filled & capped vias
    [fs.kicad_pcb]
2026-07-27 make FREQ_CTL filter cap an NP0 part
    [fs.kicad_pcb, fs.kicad_sch, out.kicad_sch, pn.kicad_sch]
2026-07-28 replace mosfet with analog switch
    [fs.kicad_pcb, fs.kicad_sch, pn.kicad_sch]
2026-07-30 better comparators for ~FAULT
    [fp.kicad_sch, fs.kicad_pcb, fs.kicad_sch, pn.kicad_sch]
2026-07-31 fix net directions
    [fp.kicad_sch, fs.kicad_pcb, fs.kicad_sch, out.kicad_sch, pn.kicad_sch]
2026-08-03 generate fabrication files
    [bom.csv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]
2026-08-03 female header moved 5 mil away from male header
    [bom.csv, fs.kicad_pcb, fs.kicad_sch, fs.step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]
